njKessel/ESP32s3-NetworkClock/docs/images/24hourClockHome.jpg

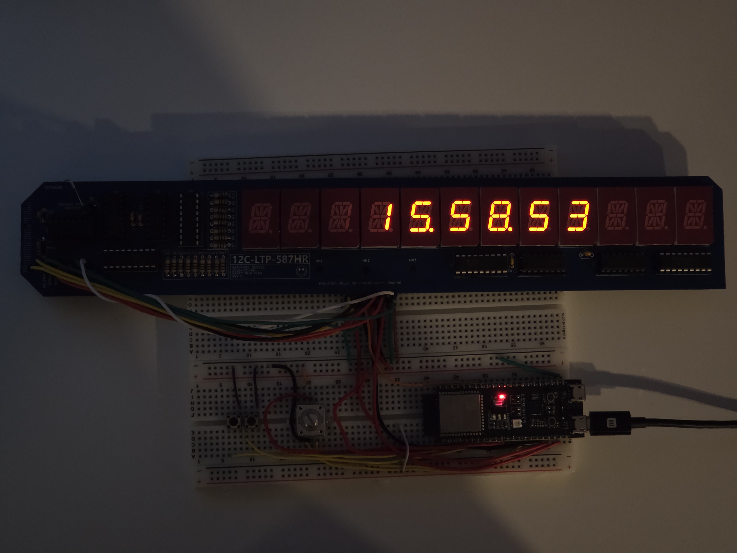
docs/images/24hourClockHome.jpg
