njKessel/ESP32s3-NetworkClock/docs/images/stopwatch.jpg

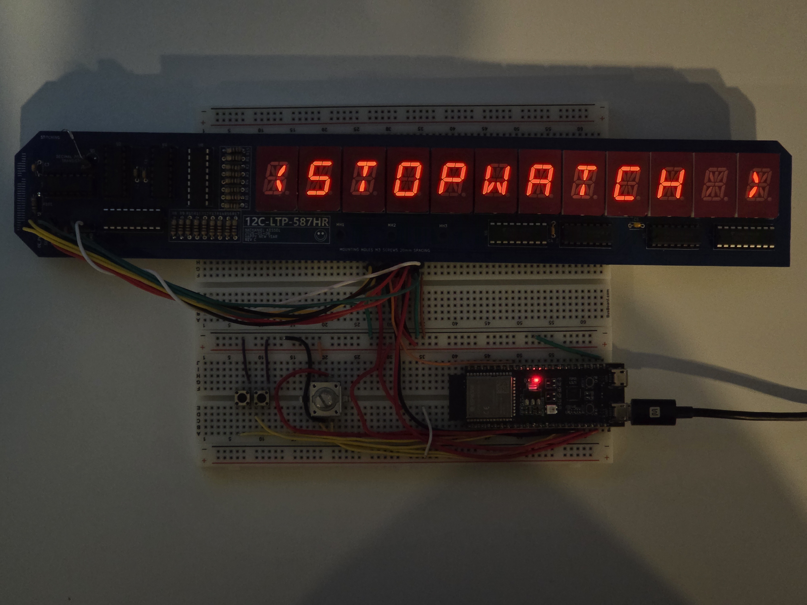
docs/images/stopwatch.jpg
