njKessel/ESP32s3-NetworkClock/README.md

# ESP32s3-NetworkClock
ESP32-S3 smart clock with LED display, weather, moon phase, temperature, Google Calendar
