njKessel/ESP32s3-NetworkClock/docs/design/2026-18-01-AlarmImplementation.pdf

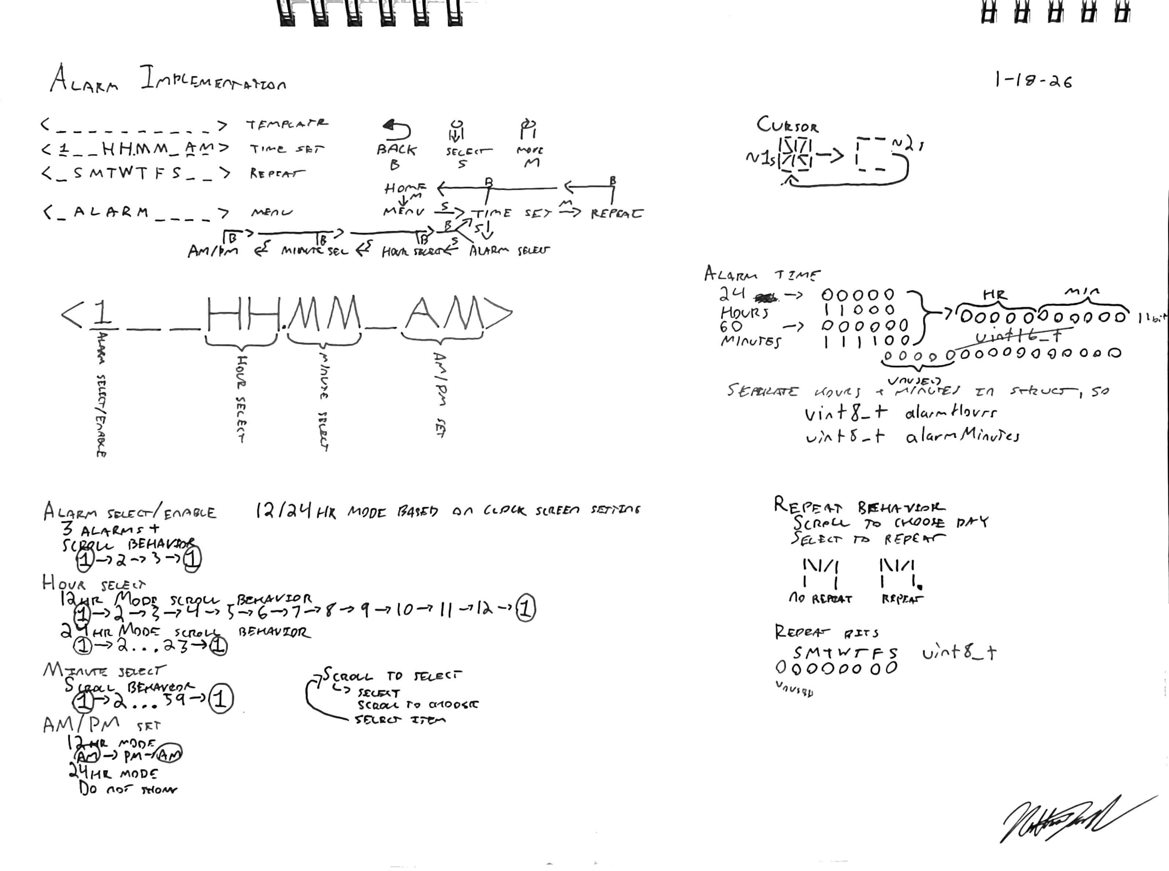
[picture p3: page 1]
