njKessel/ESP32s3-NetworkClock/docs/images/alarmEdit.jpg

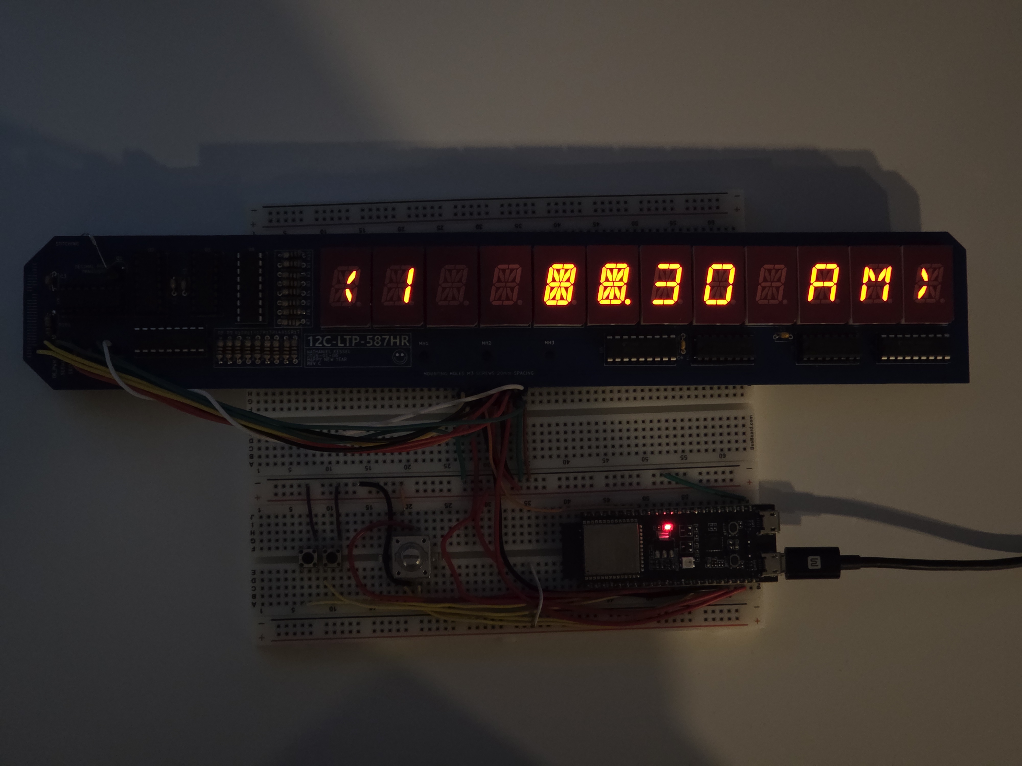
docs/images/alarmEdit.jpg
