njKessel/ESP32s3-NetworkClock/docs/images/alarmOption.jpg

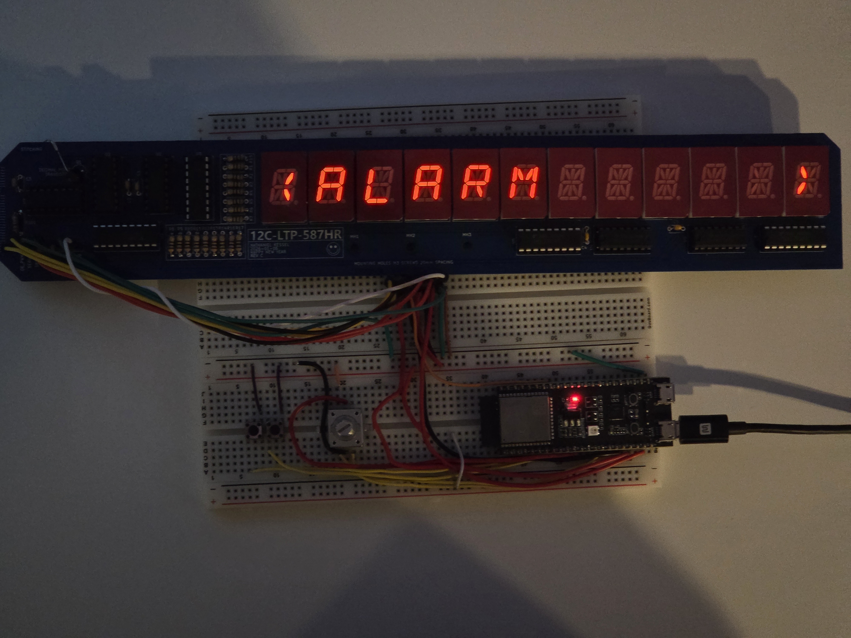
docs/images/alarmOption.jpg
