njKessel/ESP32s3-NetworkClock/docs/images/alarmRepeatScreen.jpg

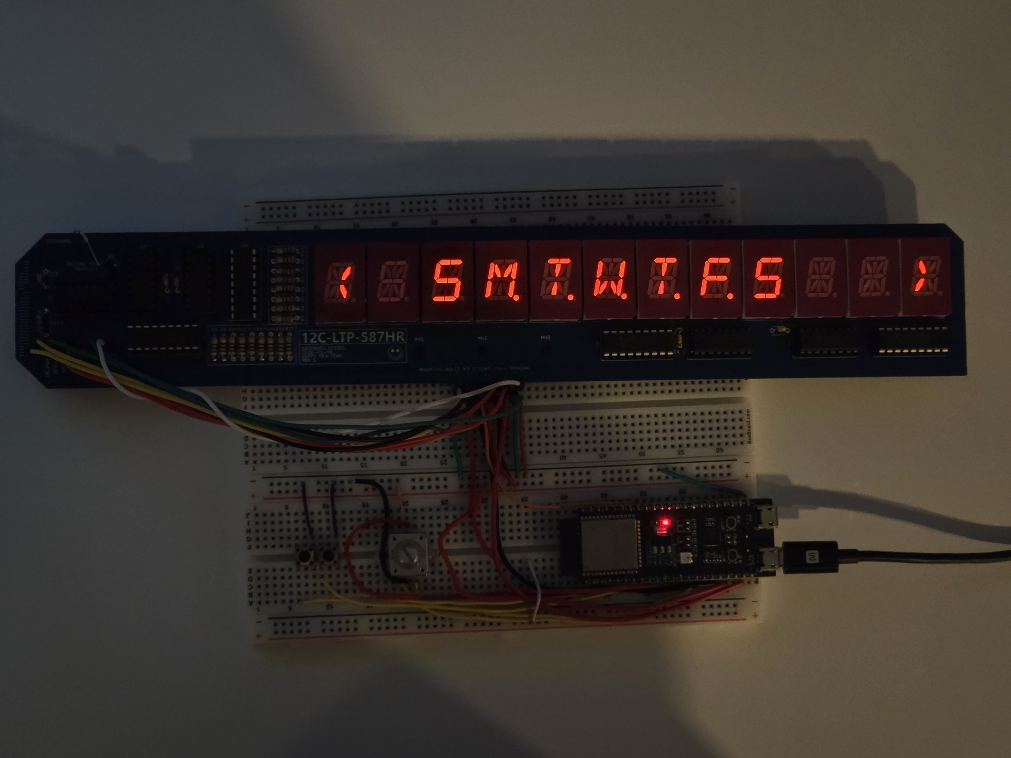
docs/images/alarmRepeatScreen.jpg
