njKessel/ESP32s3-NetworkClock/docs/images/clockHome.jpg

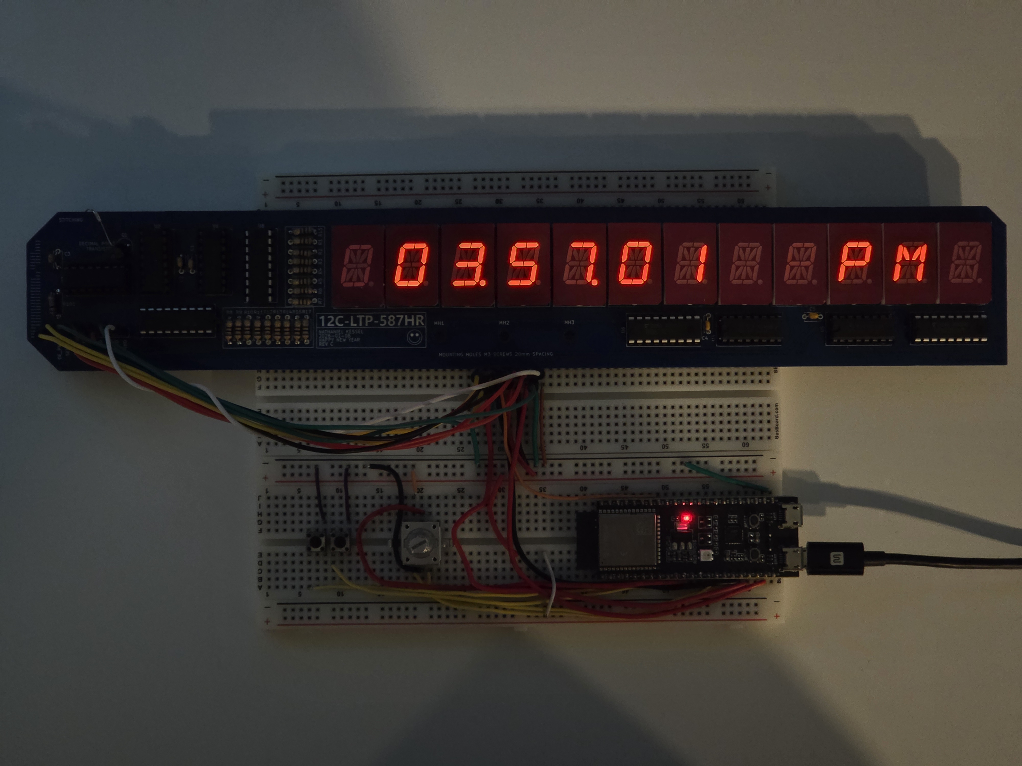
docs/images/clockHome.jpg
