njKessel/ESP32s3-NetworkClock/docs/images/clockNav.jpg

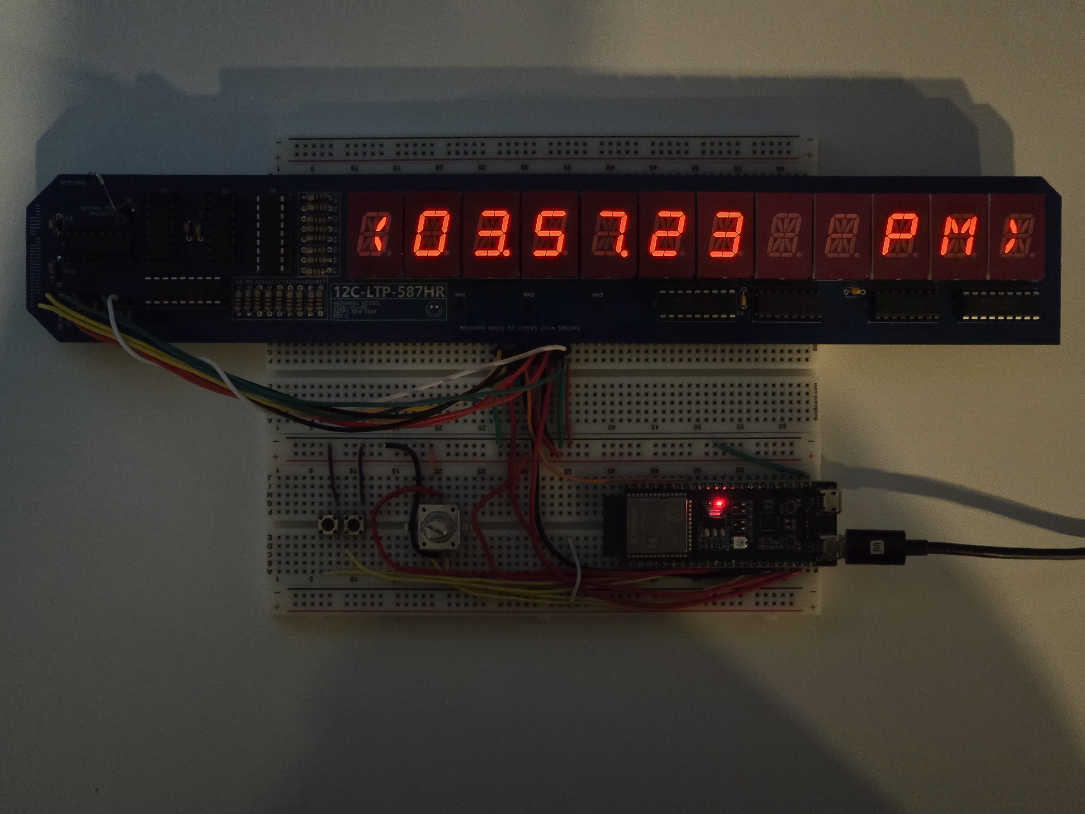
docs/images/clockNav.jpg
