njKessel/ESP32s3-NetworkClock/docs/images/timerInProgress.jpg

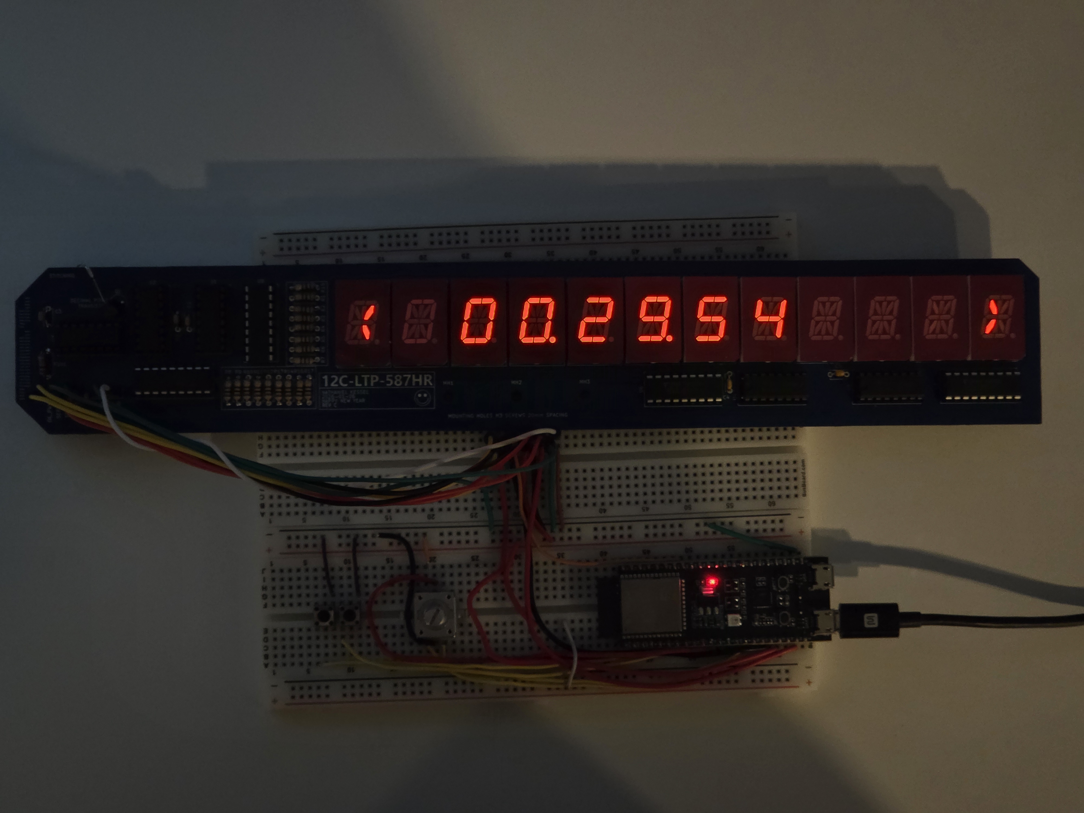
docs/images/timerInProgress.jpg
