njKessel/ESP32s3-NetworkClock/docs/images/timerNotif.jpg

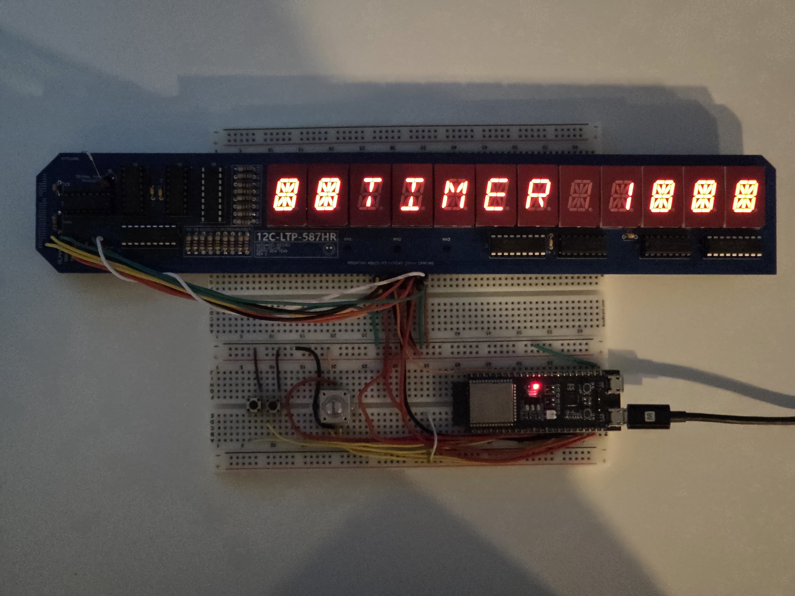
docs/images/timerNotif.jpg
