njKessel/ESP32s3-NetworkClock/docs/images/timerOption.jpg

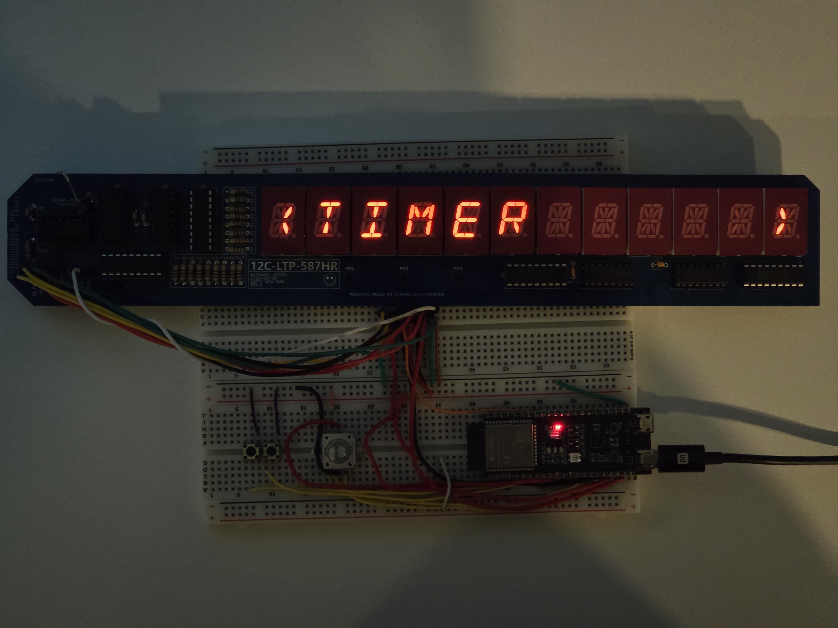
docs/images/timerOption.jpg
