njKessel/ESP32s3-NetworkClock/docs/images/timeZoneOption.jpg

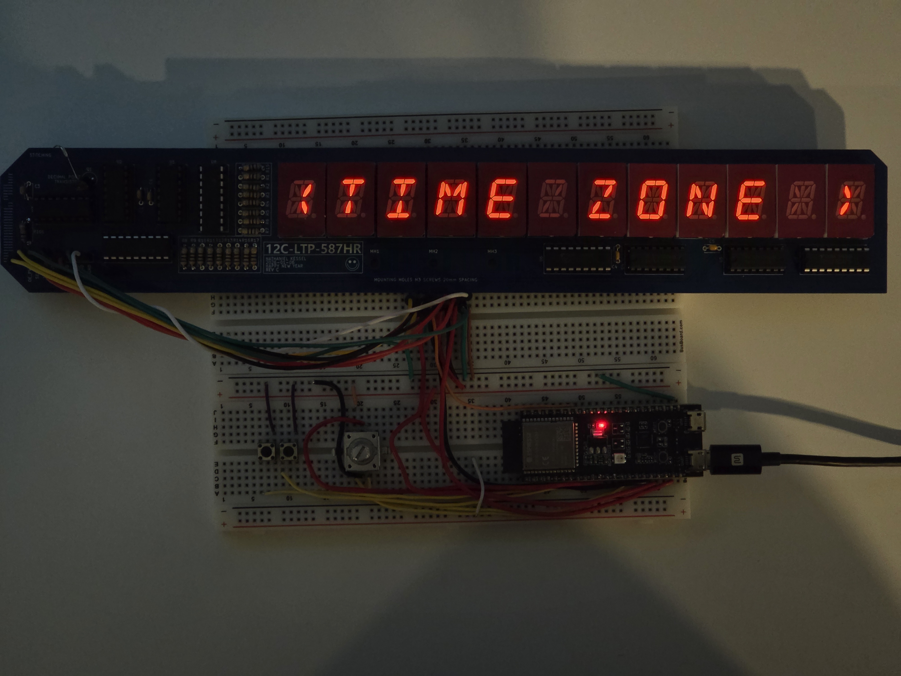
docs/images/timeZoneOption.jpg
