njKessel/ESP32s3-NetworkClock/docs/images/timeZoneSelect.jpg

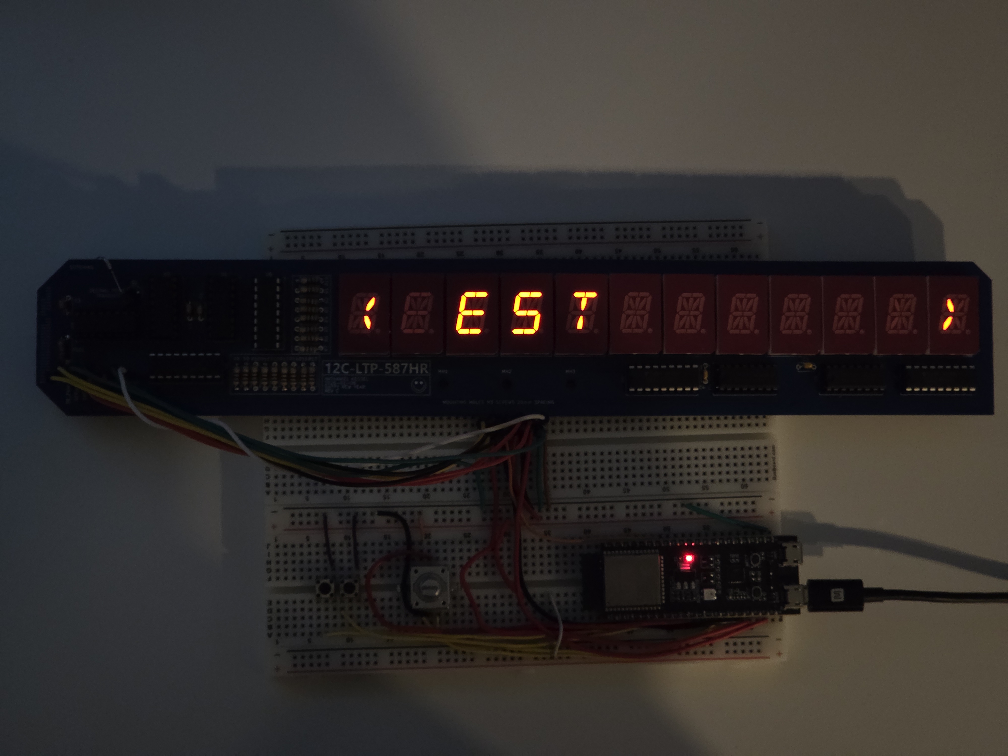
docs/images/timeZoneSelect.jpg
