njKessel/ESP32s3-NetworkClock/docs/scope/SDA_EOD2025-11-04.png

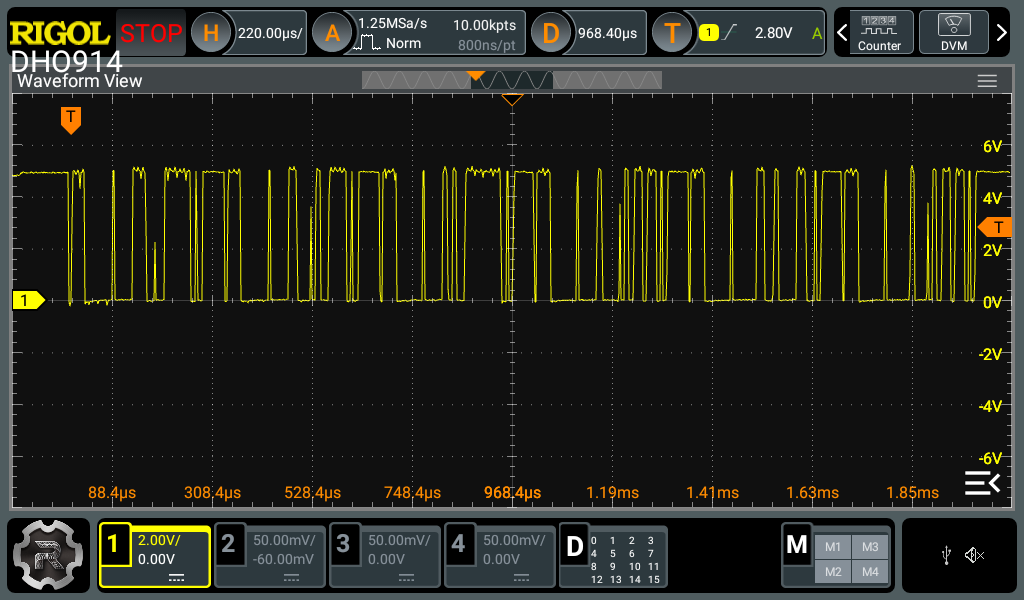
docs/scope/SDA_EOD2025-11-04.png
