njKessel/ESP32s3-NetworkClock/hardware/PCB/breadboardDisplayPCB/displayboard/displayboard.step

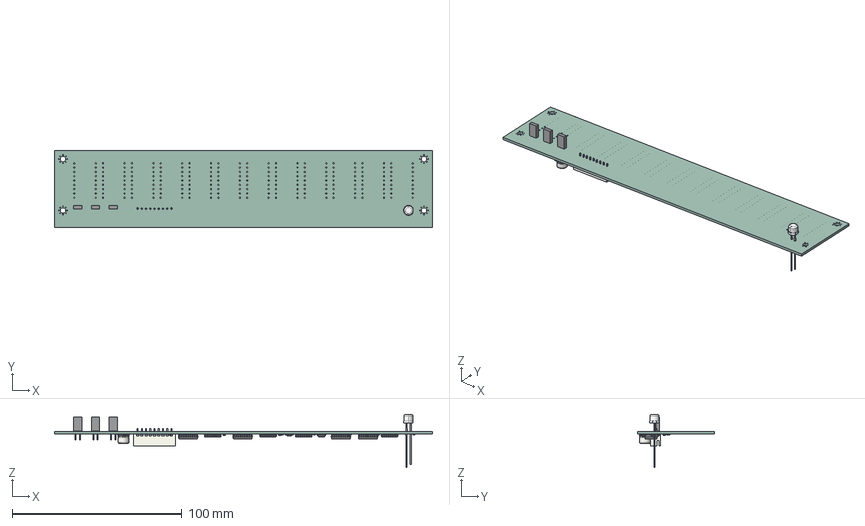
[picture p15: CAD file, 2026-04-21]
hardware/PCB/breadboardDisplayPCB/displayboard/displayboard.step
223.0 x 45.3 x 31.4 mm
TEPT5700
Leads x 3
R_0805_2012Metric x 18
SOIC-18W_7.5x11.6mm_P1.27mm x 4
C_0603_1608Metric x 6
SOIC-16_3.9x9.9mm_P1.27mm x 5
R_0603_1608Metric x 4
JST_XH_B9B-XH-A_1x09_P2.50mm_Vertical
SOT-23
CP_Elec_6.3x5.4
displayboard_PCB
