njKessel/ESP32s3-NetworkClock/hardware/PCB/breadboardDisplayPCB/displayboard/PDF/displayboard.pdf

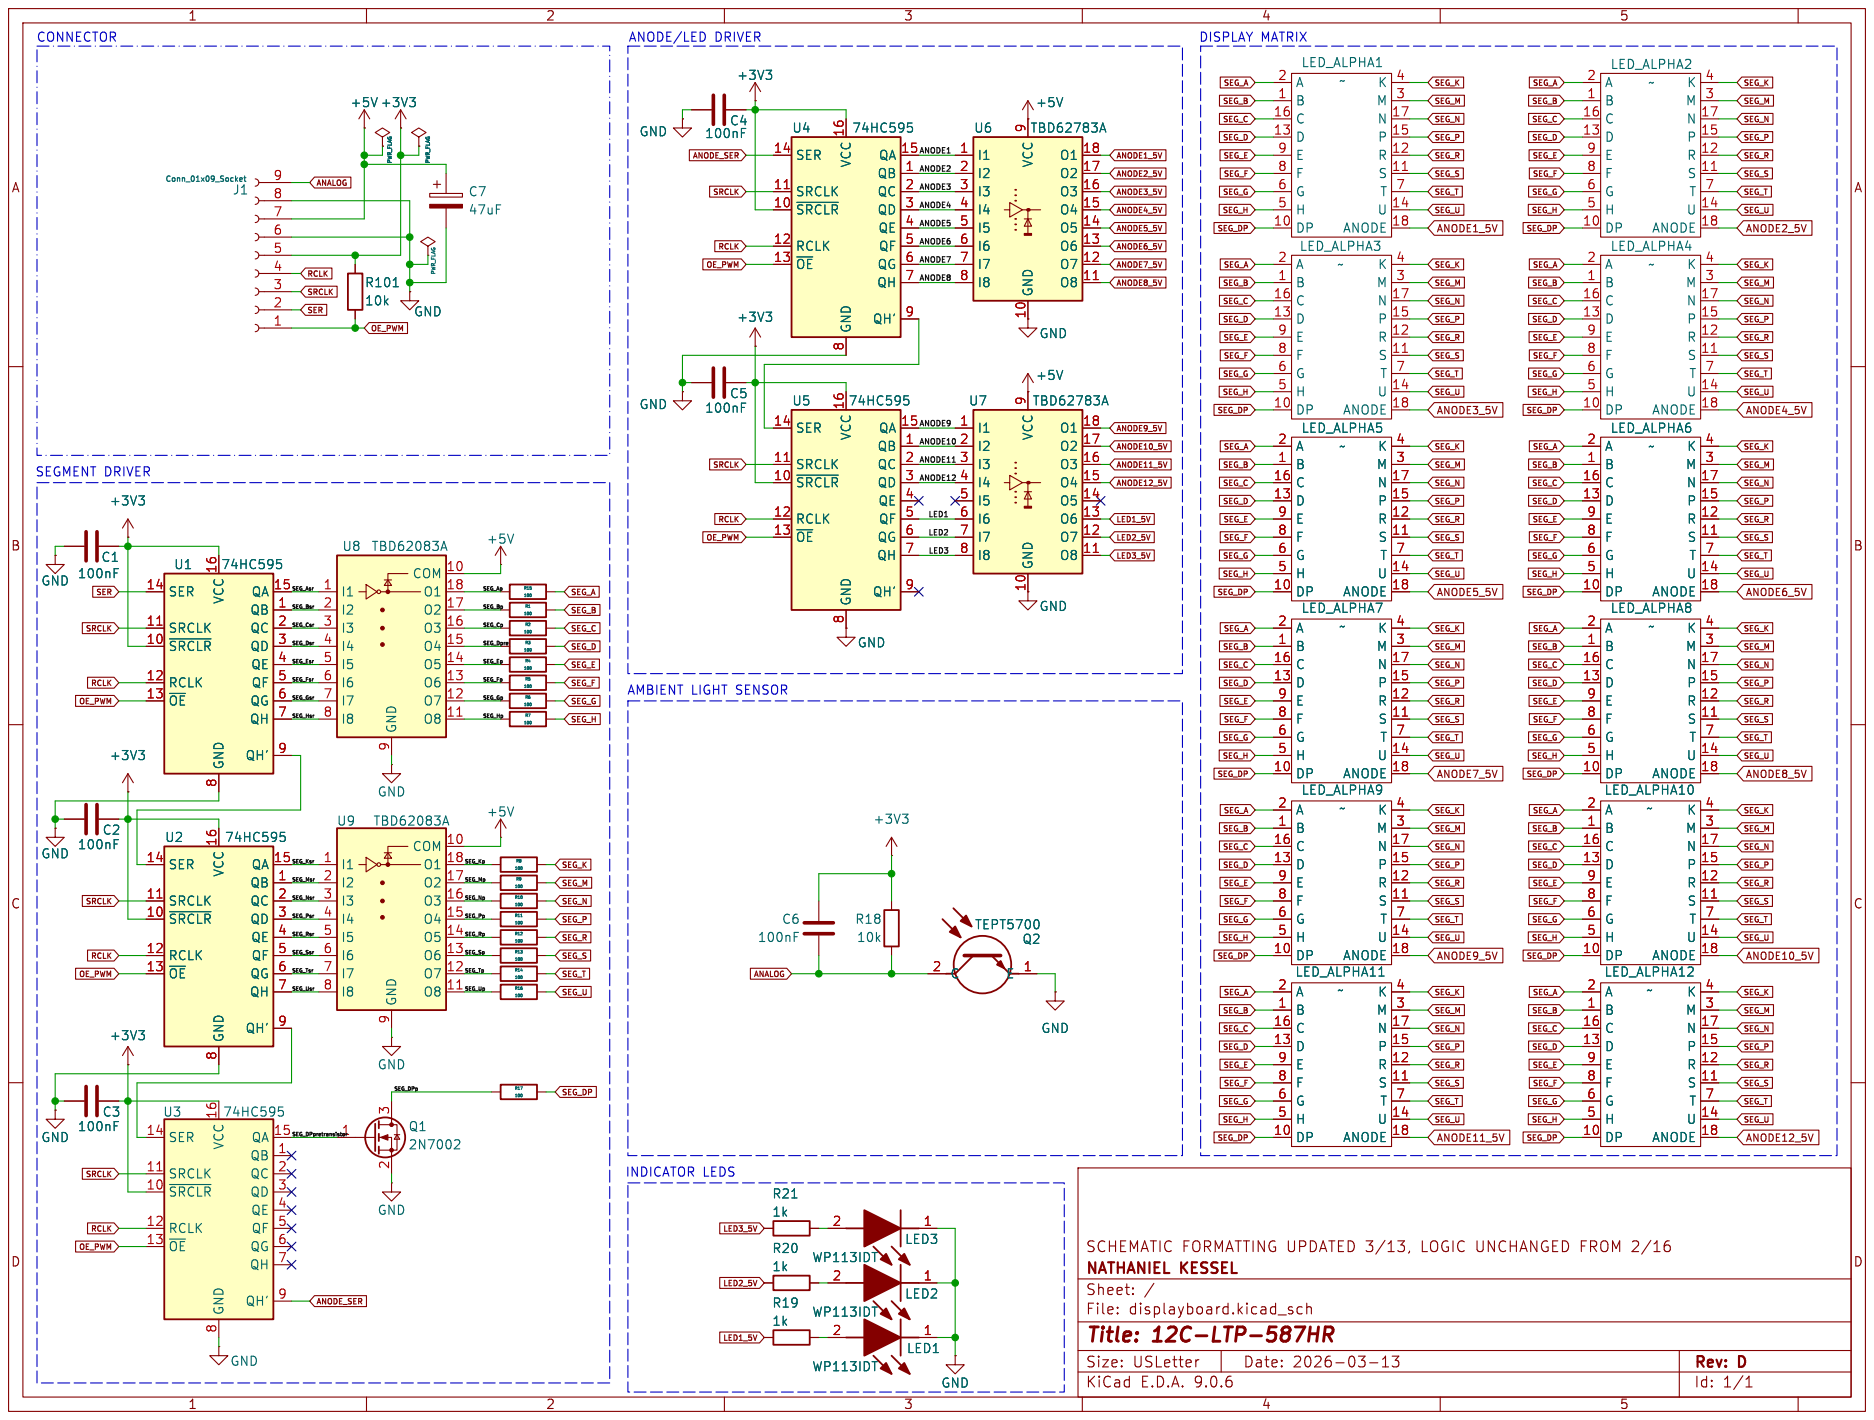
[picture p16: page 1]

8 QA 15 QB 1 QC 2 QD 3 QE 4 QF 5 QG 6 QH 7 QH' 9 GND U4 74HC595 GND

8 QA 15 QB 1 QC 2 QD 3 QE 4 QF 5 QG 6 QH 7 QH' 9 GND GND GND GND

8 QA 15 QB 1 QC 2 QD 3 QE 4 QF 5 QG 6 QH 7 QH' 9 U5 74HC595 +5V GND

8 QA 15 QB 1 QC 2 QD 3 QE 4 QF 5 QG 6 QH 7 QH' 9 +5V GND

9 GND 10 O1 18 O2 17 O3 16 O4 15 O5 14 O6 13 O7 12 O8 11 U5 74HC595 SER 14 SRCLK 11 ~{SRCLR} 10 RCLK 12 ~{OE} 13 VCC 16 GND

SER

100nFC3
1k GND GND

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
