njKessel/ESP32s3-NetworkClock/hardware/PCB/buttonPCB/buttons/PDF/buttons.pdf

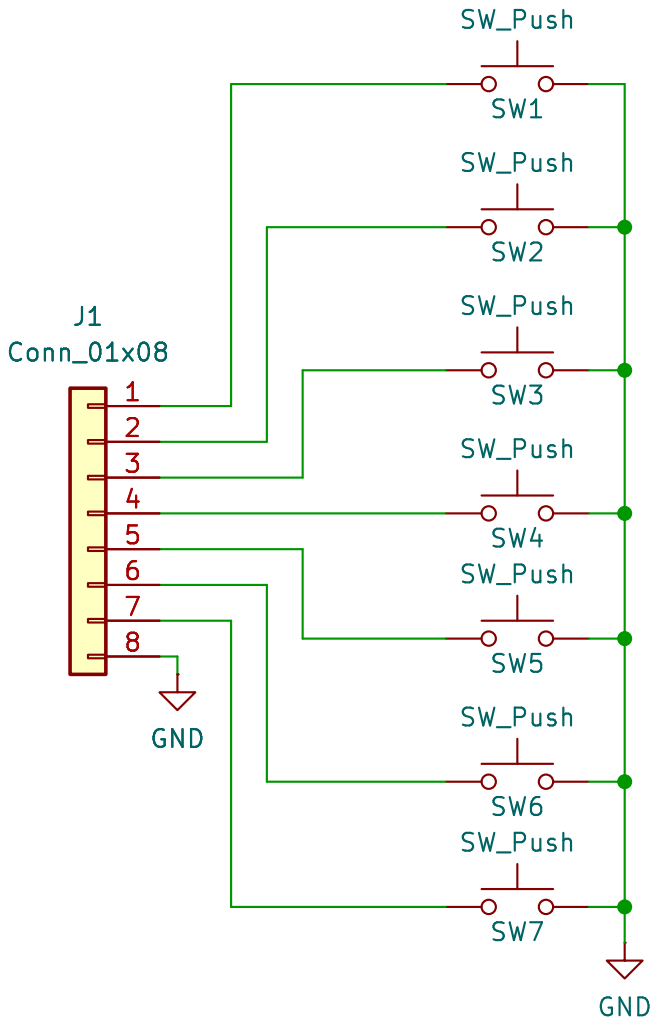
[picture p17: page 1]

Id: 1/1 Title: BUTTON PANEL FOR ESP32 CLOCK
