njKessel/ESP32s3-NetworkClock/hardware/PCB/mainClockPCB/mainClockPCB/PDF/mainClockPCB.pdf

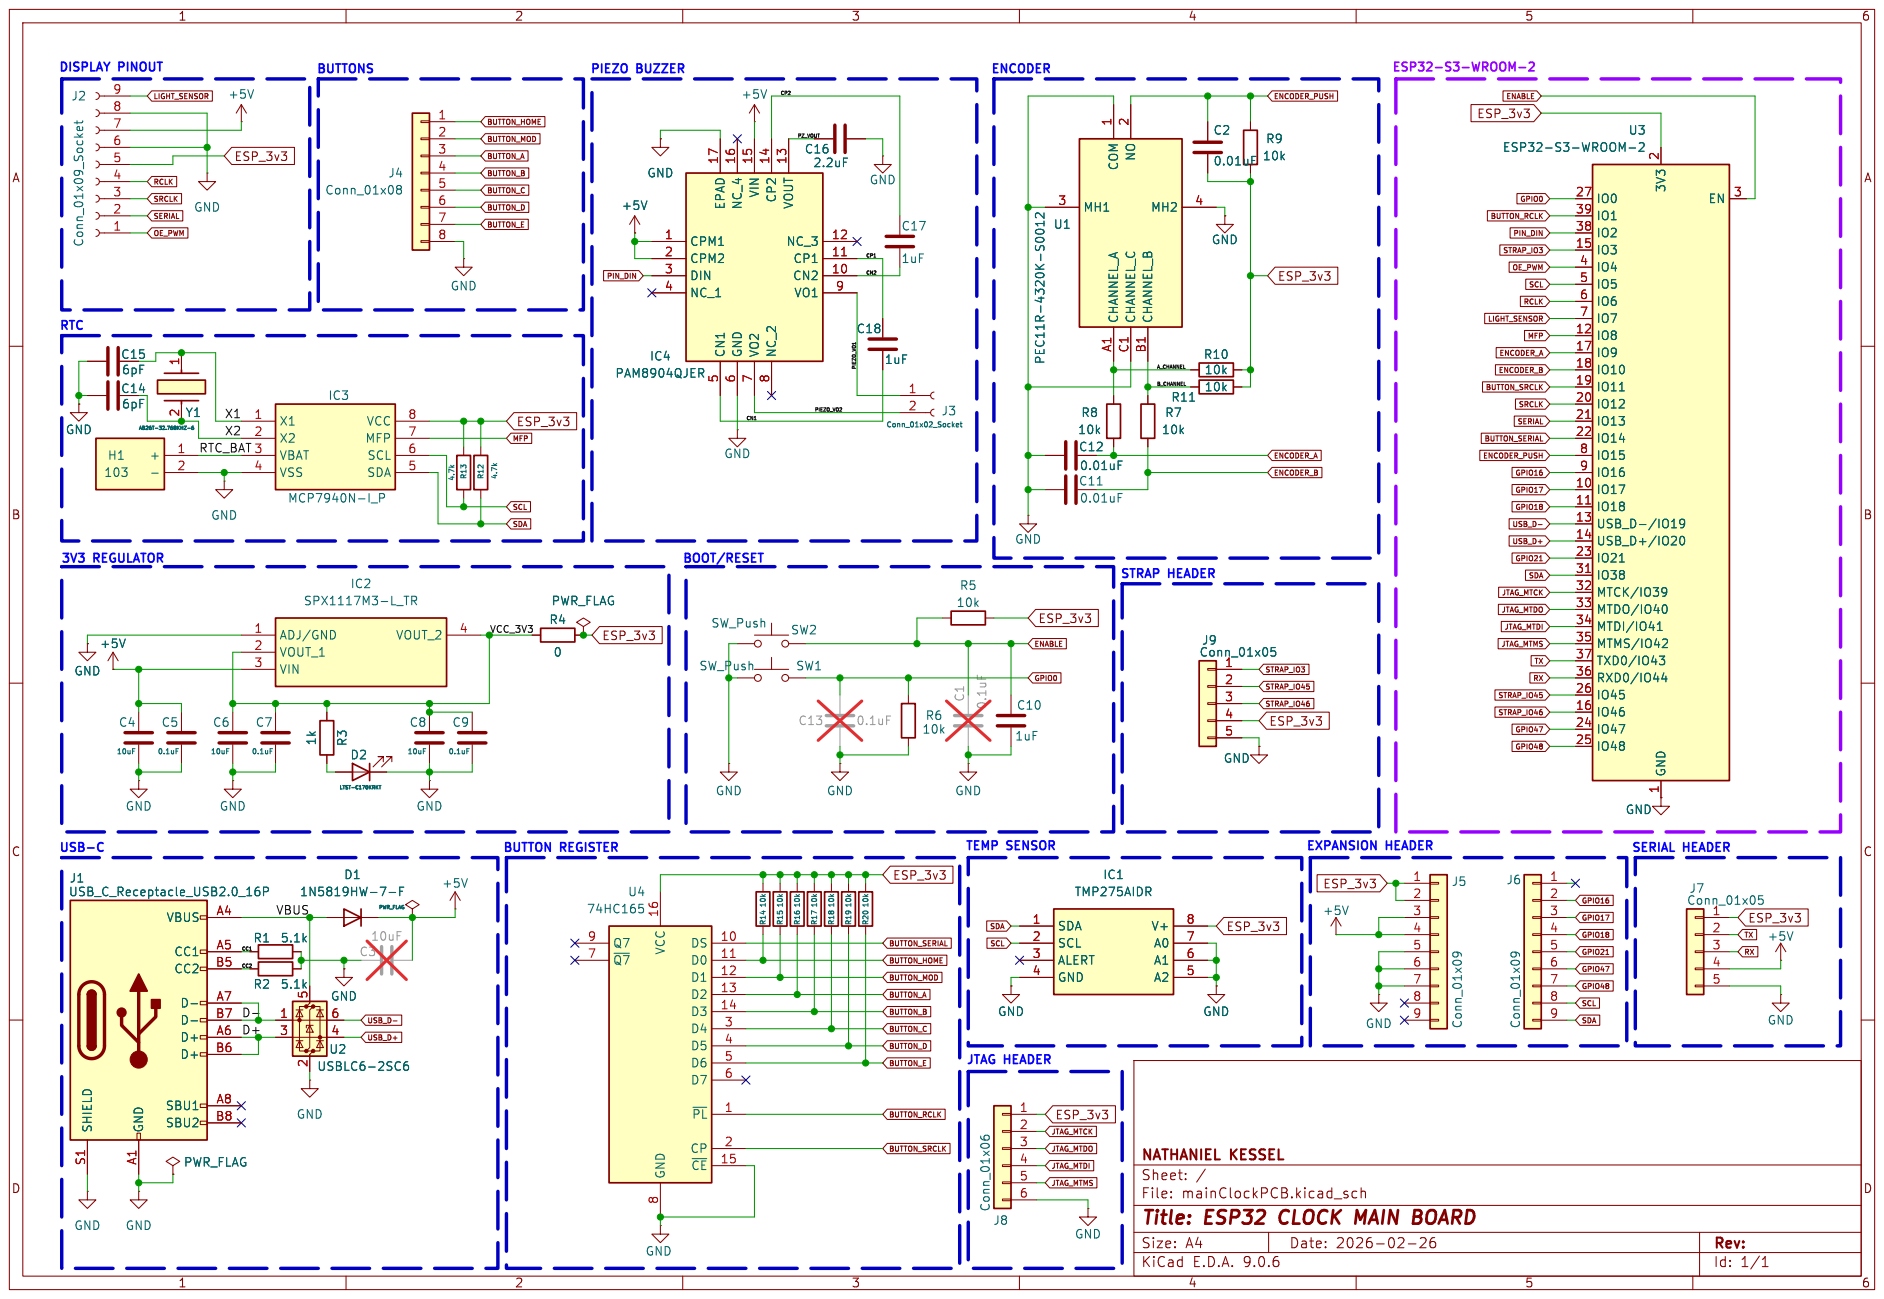
[picture p18: page 1]

2 CHANNEL_C C1 CHANNEL_B B1 MH2 4 U1 PEC11R-4320K-S0012 SDA 1 SCL 2 ALERT 3 GND 4 V+ 8 A0 7 A1 6 A2 5

IO38 31 MTCK/IO39 32 MTDO/IO40 33 MTDI/IO41 34 MTMS/IO42 35 TXD0/IO43 37 RXD0/IO44 36

Id: 1/1 Title: ESP32 CLOCK MAIN BOARD
