njKessel/ESP32s3-NetworkClock/hardware/PCB/breadboardDisplayPCB/displayboard/PDF/displayboard-B_Cu.pdf

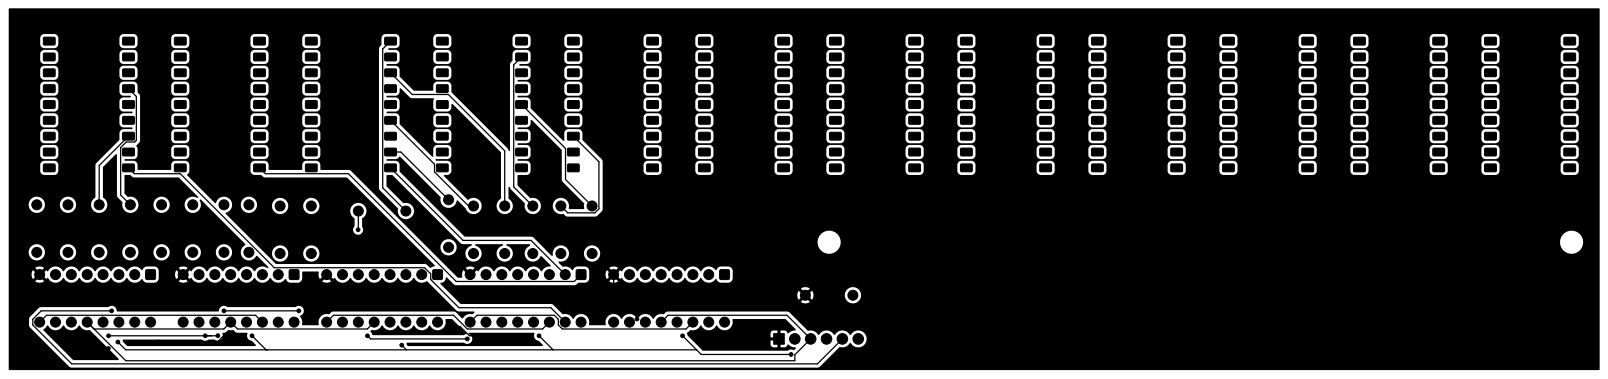
[picture p19: page 1]
