njKessel/ESP32s3-NetworkClock/hardware/PCB/breadboardDisplayPCB/displayboard/PDF/displayboard-B_Mask.pdf

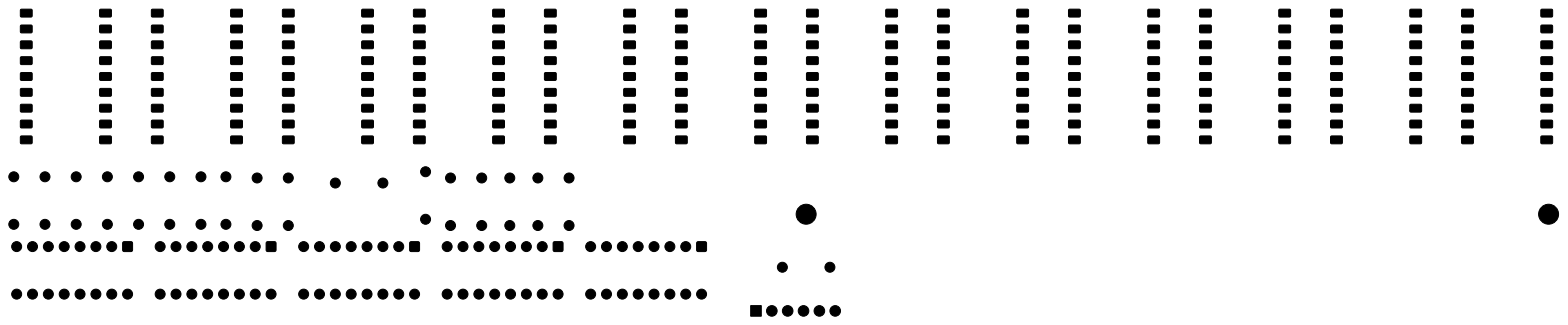
[picture p20: page 1]
