njKessel/ESP32s3-NetworkClock/hardware/PCB/breadboardDisplayPCB/displayboard/PDF/displayboard-B_Paste.pdf

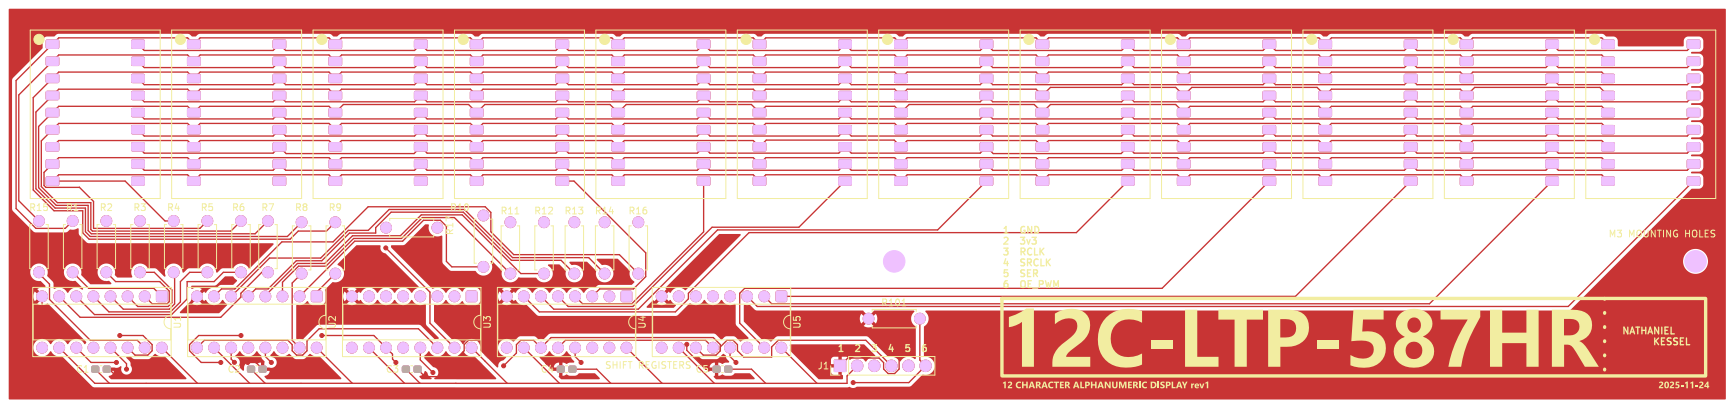
[picture p21: page 1]
