njKessel/ESP32s3-NetworkClock/hardware/PCB/breadboardDisplayPCB/displayboard/PDF/displayboard-B_Silkscreen.pdf

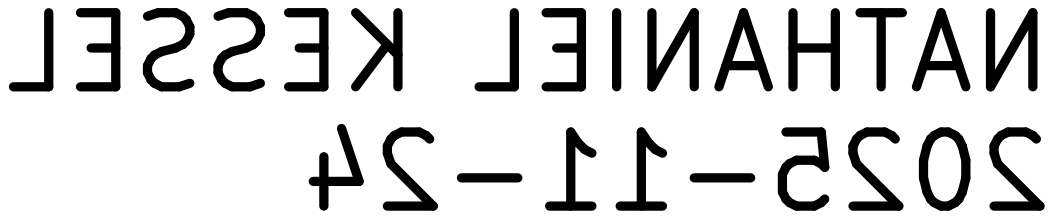
[picture p22: page 1]
