njKessel/ESP32s3-NetworkClock/hardware/PCB/breadboardDisplayPCB/displayboard/PDF/displayboard-F_Cu.pdf

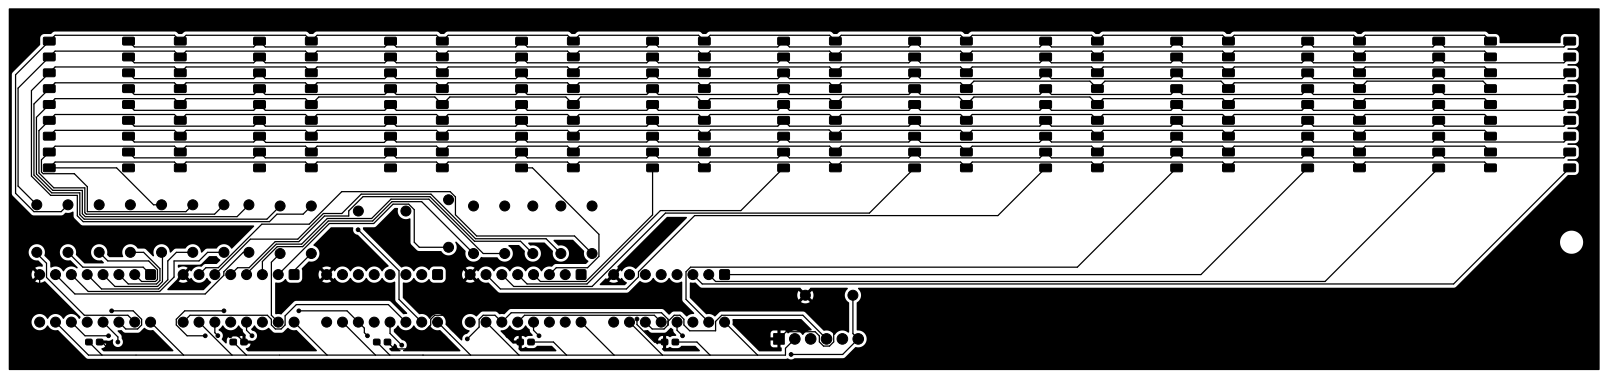
[picture p23: page 1]
