njKessel/ESP32s3-NetworkClock/hardware/PCB/breadboardDisplayPCB/displayboard/PDF/displayboard-F_Silkscreen.pdf

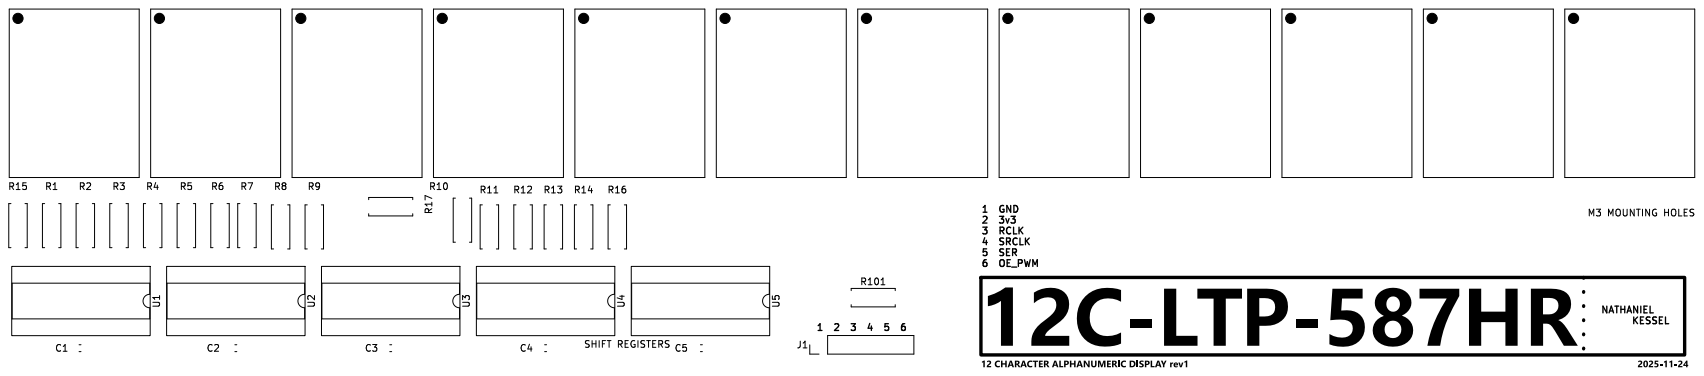
[picture p26: page 1]
