njKessel/ESP32s3-NetworkClock/hardware/PCB/mainClockPCB/mainClockPCB/mainClockPCB.kicad_pcb

## KiCad design hardware/PCB/mainClockPCB/mainClockPCB/mainClockPCB.kicad_pcb (2026-08-13)

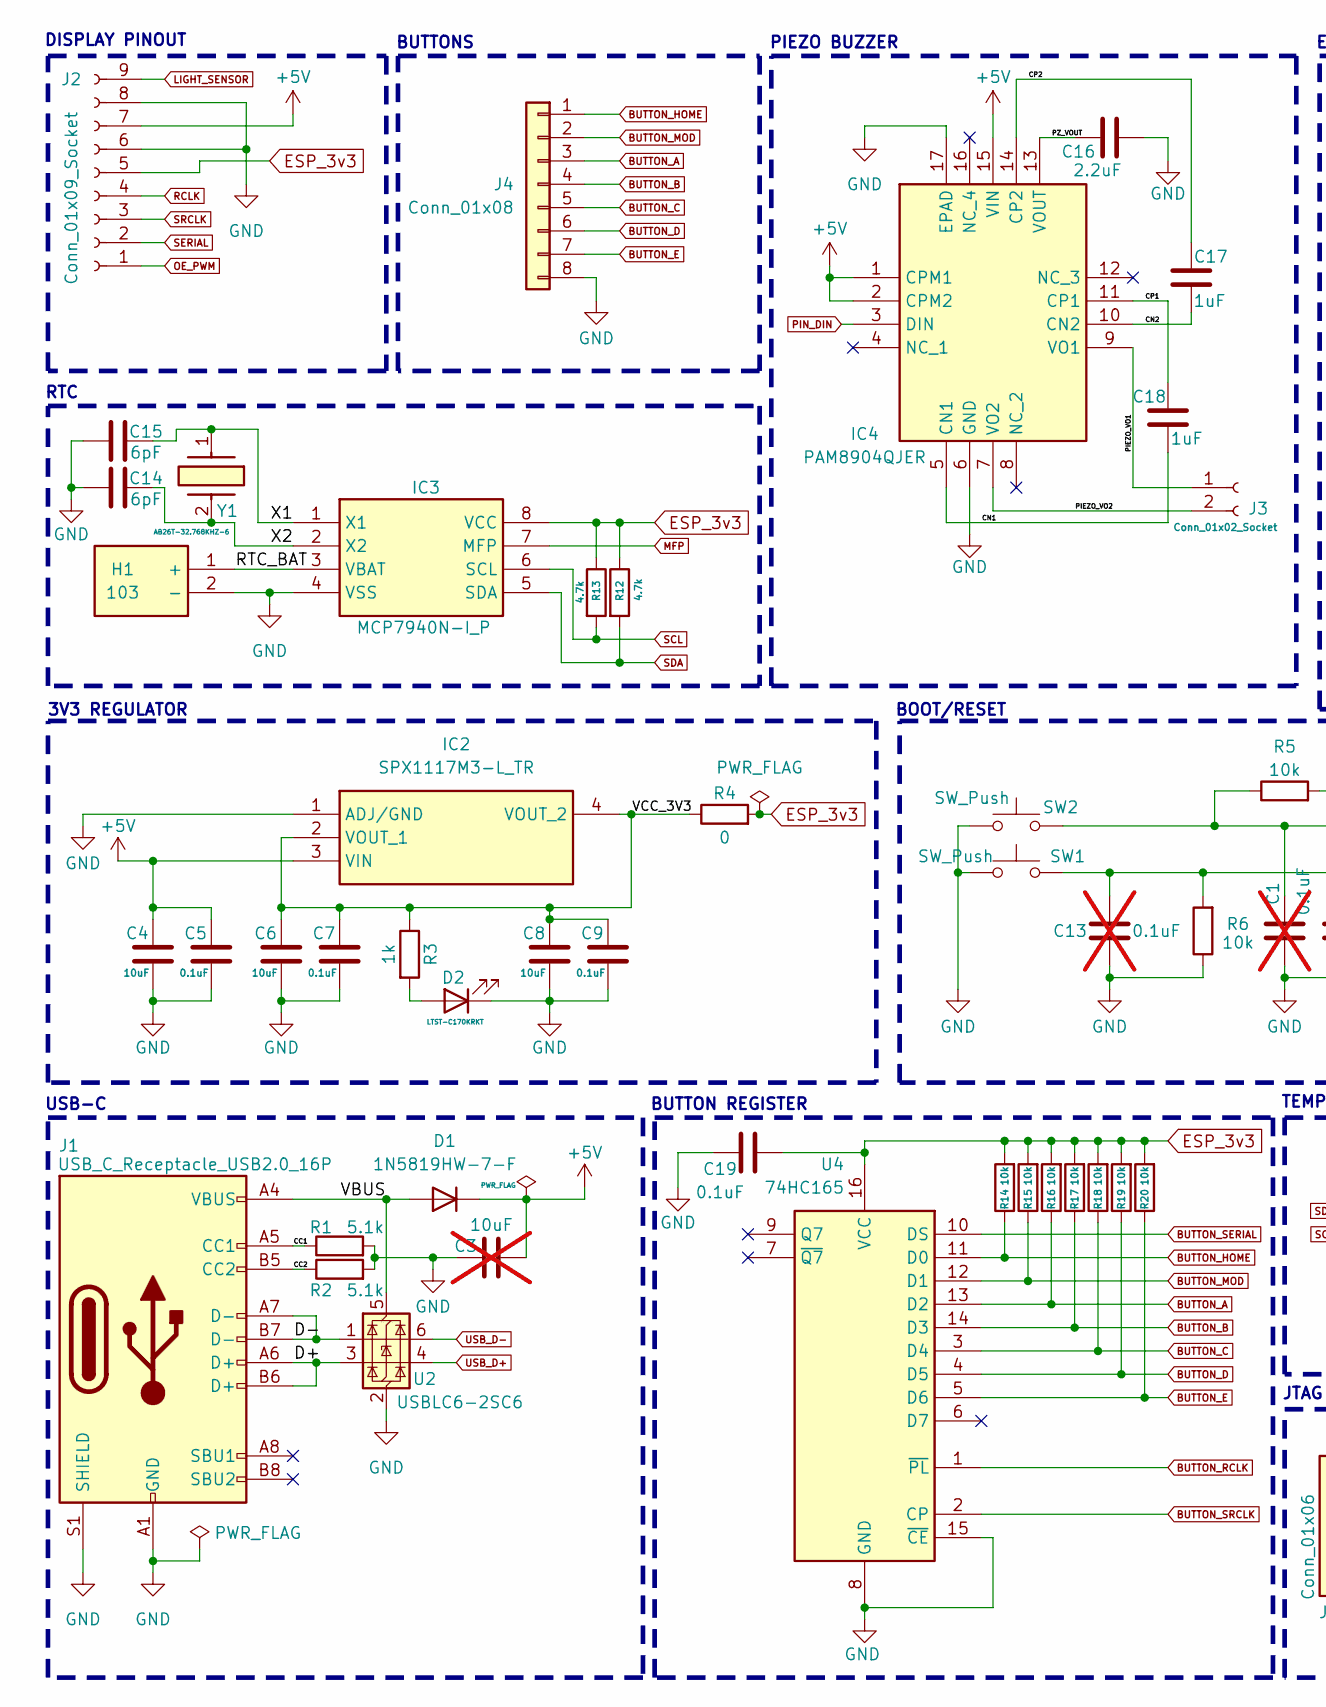
[picture p27: schematic mainClockPCB.kicad_sch, ESP32 CLOCK MAIN BOARD, part in row 1, column 1]

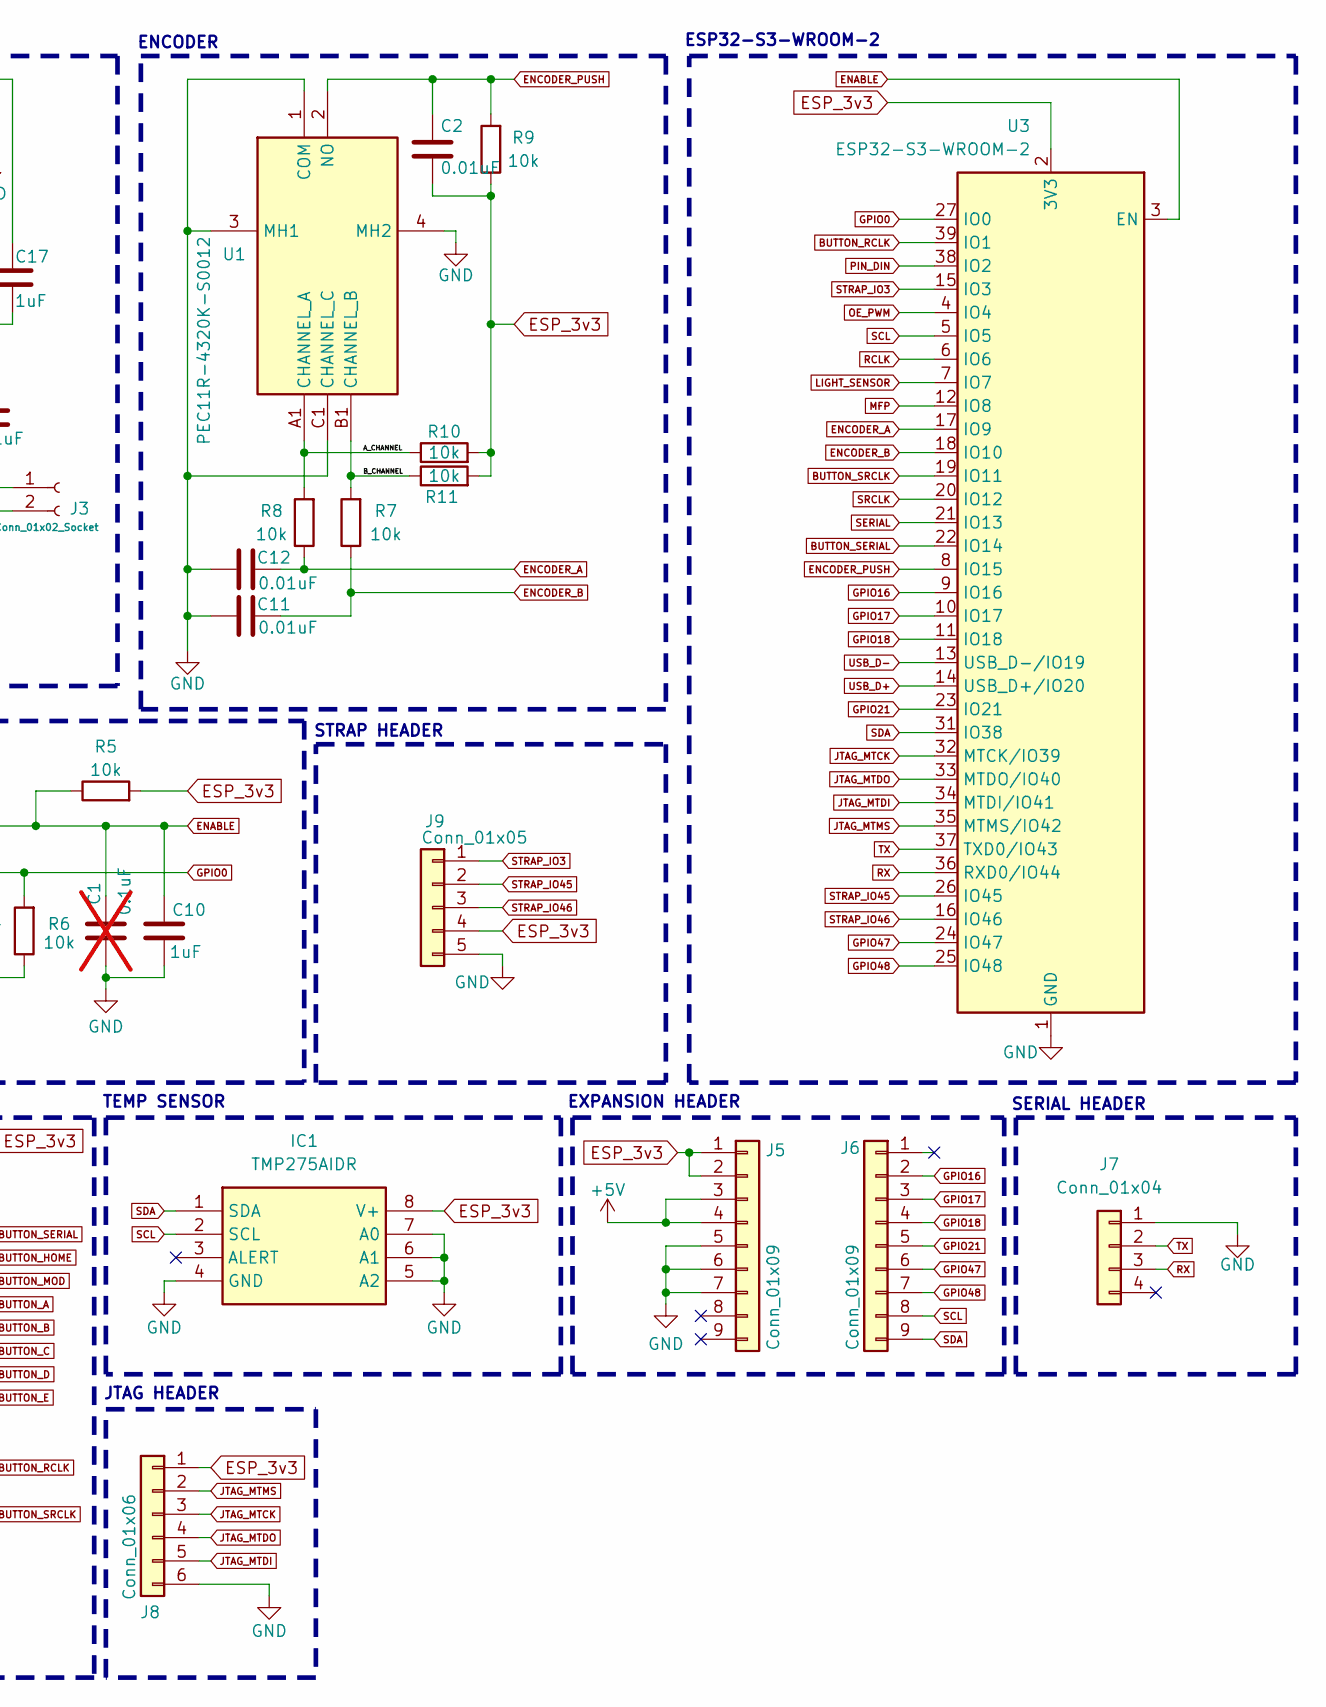
[picture p28: schematic mainClockPCB.kicad_sch, ESP32 CLOCK MAIN BOARD, part in row 1, column 2]

Parts:
C1, C13: 0.1uF; C_0603_1608Metric_Pad1.08x0.95mm_HandSolder; Voltage 50V; Tolerance 10%; not fitted
C2, C11, C12: 0.01uF; C_0603_1608Metric_Pad1.08x0.95mm_HandSolder
C3: 10uF; C_0805_2012Metric_Pad1.18x1.45mm_HandSolder; not fitted
C4, C6, C8: 10uF; C_0805_2012Metric_Pad1.18x1.45mm_HandSolder
C5, C7, C9, C19: 0.1uF; C_0603_1608Metric_Pad1.08x0.95mm_HandSolder
C10, C17, C18: 1uF; C_0603_1608Metric_Pad1.08x0.95mm_HandSolder
C14, C15: 6pF; C_0603_1608Metric_Pad1.08x0.95mm_HandSolder
C16: 2.2uF; C_0603_1608Metric_Pad1.08x0.95mm_HandSolder
D1: 1N5819HW-7-F; D_SOD-123
D2: LTST-C170KRKT; LED_0805_2012Metric_Pad1.15x1.40mm_HandSolder
H1: 103; Manufacturer_Part_Number 103; Mouser Part Number 534-103
IC1: TMP275AIDR; SOIC127P600X175-8N; Manufacturer_Part_Number TMP275AIDR; Mouser Part Number 595-TMP275AIDR
IC2: SPX1117M3-L_TR; SOT230P700X180-4N; Manufacturer_Part_Number SPX1117M3-L/TR; Mouser Part Number 701-SPX1117M3-L/TR
IC3: MCP7940N-I_P; DIP781W56P254L950H533Q8N; Manufacturer_Part_Number MCP7940N-I/P; Mouser Part Number 579-MCP7940N-I/P
IC4: PAM8904QJER; QFN50P300X300X65-17N-D; Manufacturer_Part_Number PAM8904QJER; Mouser Part Number 621-PAM8904QJER
J1: USB_C_Receptacle_USB2.0_16P; USB_C_Receptacle_GCT_USB4085
J2: Conn_01x09_Socket; JST_XH_B9B-XH-A_1x09_P2.50mm_Vertical
J3: Conn_01x02_Socket; JST_XH_B2B-XH-A_1x02_P2.50mm_Vertical
J4: Conn_01x08; JST_XH_B8B-XH-A_1x08_P2.50mm_Vertical
J5, J6: Conn_01x09; PinSocket_1x09_P2.54mm_Vertical
J7: Conn_01x04; PinSocket_1x04_P2.54mm_Vertical
J8: Conn_01x06; PinSocket_1x06_P2.54mm_Vertical
J9: Conn_01x05; PinSocket_1x05_P2.54mm_Vertical
R1, R2: 5.1k; R_0603_1608Metric_Pad0.98x0.95mm_HandSolder
R3: 1k; R_0603_1608Metric_Pad0.98x0.95mm_HandSolder
R4: 0; R_0603_1608Metric_Pad0.98x0.95mm_HandSolder
R5, R6, R7, R8, R9, R10, R11, R14, R15, R16, R17, R18, R19, R20: 10k; R_0603_1608Metric_Pad0.98x0.95mm_HandSolder
R12, R13: 4.7k; R_0603_1608Metric_Pad0.98x0.95mm_HandSolder
SW1, SW2: SW_Push; SW_PUSH_6mm_H5mm
U1: PEC11R-4320K-S0012; PEC11R4320KS0012; Manufacturer_Part_Number PEC11R-4320K-S0012; Mouser Part Number 652-PEC11R-4320K-S12
U2: USBLC6-2SC6; SOT-23-6
U3: ESP32-S3-WROOM-2
U4: 74HC165; DIP-16_W7.62mm_Socket
Y1: AB26T-32.768KHZ-6; AB26T32768KHZ6; Manufacturer_Part_Number AB26T-32.768KHZ-6; Mouser Part Number 815-AB26T-32.768K-6

Connections:
+5V: C3.2, C4.1, C5.1, D1.1 (K), IC2.3 (VIN), IC4.1 (CPM1), IC4.2 (CPM2), IC4.15 (VIN), J2.7, J5.3, J5.4
/A_CHANNEL: R8.2, R10.1, U1.A1 (CHANNEL_A)
/B_CHANNEL: R7.2, R11.1, U1.B1 (CHANNEL_B)
/CC1: J1.A5 (CC1), R1.1
/CC2: J1.B5 (CC2), R2.1
/CN1: C18.1, IC4.5 (CN1)
/CN2: C17.1, IC4.10 (CN2)
/CP1: C18.2, IC4.11 (CP1)
/CP2: C17.2, IC4.14 (CP2)
/D+: J1.A6 (D+), J1.B6 (D+), U2.3 (I/O2)
/D-: J1.A7 (D-), J1.B7 (D-), U2.1 (I/O1)
/PIEZO_VO1: IC4.9 (VO1), J3.1
/PIEZO_VO2: IC4.7 (VO2), J3.2
/PZ_VOUT: C16.1, IC4.13 (VOUT)
/RTC_BAT: H1.1 (+), IC3.3 (VBAT)
/VBUS: D1.2 (A), J1.A4 (VBUS), J1.A9 (VBUS), J1.B4 (VBUS), J1.B9 (VBUS), U2.5 (VBUS)
/VCC_3V3: C6.1, C7.1, C8.1, C9.1, IC2.2 (VOUT_1), IC2.4 (VOUT_2), R3.1, R4.1
/X1: C15.2, IC3.1 (X1), Y1.1
/X2: C14.2, IC3.2 (X2), Y1.2
BUTTON_A: J4.3, R16.1, U4.13 (D2)
BUTTON_B: J4.4, R17.1, U4.14 (D3)
BUTTON_C: J4.5, R18.1, U4.3 (D4)
BUTTON_D: J4.6, R19.1, U4.4 (D5)
BUTTON_E: J4.7, R20.1, U4.5 (D6)
BUTTON_HOME: J4.1, R14.1, U4.11 (D0)
BUTTON_MOD: J4.2, R15.1, U4.12 (D1)
BUTTON_RCLK: U3.39 (IO1), U4.1 (~PL)
BUTTON_SERIAL: U3.22 (IO14), U4.10 (DS)
BUTTON_SRCLK: U3.19 (IO11), U4.2 (CP)
ENABLE: C1.1, C10.1, R5.1, SW2.2, U3.3 (EN)
ENCODER_A: C12.2, R8.1, U3.17 (IO9)
ENCODER_B: C11.1, R7.1, U3.18 (IO10)
ENCODER_PUSH: C2.1, R9.2, U1.2 (NO), U3.8 (IO15)
ESP_3v3: C2.2, C19.2, IC1.8 (V+), IC3.8 (VCC), J2.5, J5.1, J5.2, J8.1, J9.4, R4.2, R5.2, R9.1, R10.2, R11.2, R12.1, R13.1, R14.2, R15.2, R16.2, R17.2, R18.2, R19.2, R20.2, U3.2 (3V3), U4.16 (VCC)
GND: C1.2, C3.1, C4.2, C5.2, C6.2, C7.2, C8.2, C9.2, C10.2, C11.2, C12.1, C13.2, C14.1, C15.1, C16.2, C19.1, D2.1 (K), H1.2 (-), IC1.4 (GND), IC1.5 (A2), IC1.6 (A1), IC1.7 (A0), IC2.1 (ADJ/GND), IC3.4 (VSS), IC4.6 (GND), IC4.17 (EPAD), J1.A1 (GND), J1.A12 (GND), J1.B1 (GND), J1.B12 (GND), J1.S1 (SHIELD), J2.6, J2.8, J4.8, J5.5, J5.6, J5.7, J7.1, J8.6, J9.5, R1.2, R2.2, R6.1, SW1.1, SW2.1, U1.1 (COM), U1.3 (MH1), U1.4 (MH2), U1.C1 (CHANNEL_C), U2.2 (GND), U3.1 (GND), U3.40 (GND), U3.41 (GND), U4.8 (GND), U4.15 (~CE)
GPIO0: C13.1, R6.2, SW1.2, U3.27 (IO0)
GPIO16: J6.2, U3.9 (IO16)
GPIO17: J6.3, U3.10 (IO17)
GPIO18: J6.4, U3.11 (IO18)
GPIO21: J6.5, U3.23 (IO21)
GPIO47: J6.6, U3.24 (IO47)
GPIO48: J6.7, U3.25 (IO48)
JTAG_MTCK: J8.3, U3.32 (MTCK/IO39)
JTAG_MTDI: J8.5, U3.34 (MTDI/IO41)
JTAG_MTDO: J8.4, U3.33 (MTDO/IO40)
JTAG_MTMS: J8.2, U3.35 (MTMS/IO42)
LIGHT_SENSOR: J2.9, U3.7 (IO7)
MFP: IC3.7 (MFP), U3.12 (IO8)
unnamed: D2.2 (A), R3.2
OE_PWM: J2.1, U3.4 (IO4)
PIN_DIN: IC4.3 (DIN), U3.38 (IO2)
RCLK: J2.4, U3.6 (IO6)
RX: J7.3, U3.36 (RXD0/IO44)
SCL: IC1.2 (SCL), IC3.6 (SCL), J6.8, R13.2, U3.5 (IO5)
SDA: IC1.1 (SDA), IC3.5 (SDA), J6.9, R12.2, U3.31 (IO38)
SERIAL: J2.2, U3.21 (IO13)
SRCLK: J2.3, U3.20 (IO12)
STRAP_IO3: J9.1, U3.15 (IO3)
STRAP_IO45: J9.2, U3.26 (IO45)
STRAP_IO46: J9.3, U3.16 (IO46)
TX: J7.2, U3.37 (TXD0/IO43)
USB_D+: U2.4 (I/O2), U3.14 (USB_D+/IO20)
USB_D-: U2.6 (I/O1), U3.13 (USB_D-/IO19)

Notes on the sheet:
ESP32-S3-WROOM-2
TEMP SENSOR
EXPANSION HEADER
BUTTONS
BOOT/RESET
DISPLAY PINOUT
USB-C
JTAG HEADER
SERIAL HEADER
BUTTON REGISTER
3V3 REGULATOR
PIEZO BUZZER
RTC
STRAP HEADER
ENCODER

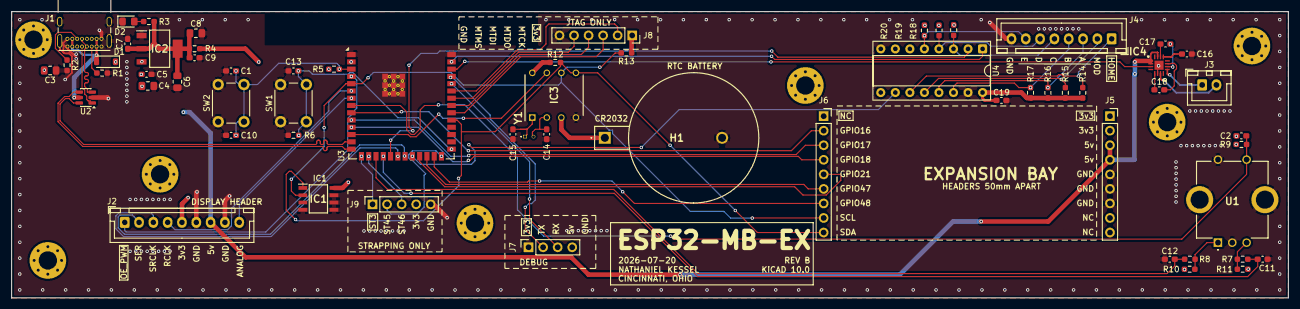
[picture p29: board mainClockPCB.kicad_pcb from above]

Board: 4 copper layers, 223.0 x 50.0 mm, 62 parts (0 on the bottom side), 63 nets.
