njKessel/ESP32s3-NetworkClock/hardware/PCB/buttonPCB/buttons/buttons.kicad_pcb

## KiCad design hardware/PCB/buttonPCB/buttons/buttons.kicad_pcb (2026-04-23)

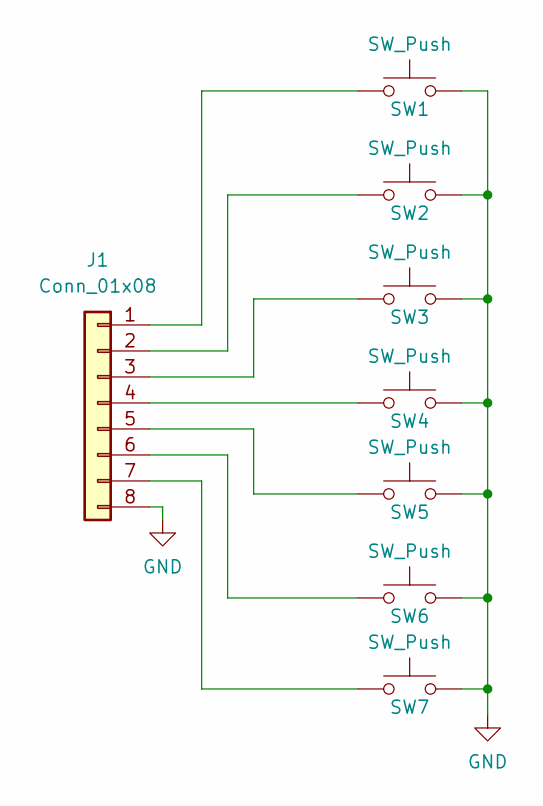
[picture p30: schematic buttons.kicad_sch, BUTTON PANEL FOR ESP32 CLOCK]

Parts:
J1: Conn_01x08; JST_XH_B8B-XH-A_1x08_P2.50mm_Vertical
SW1, SW2, SW3, SW4, SW5, SW6, SW7: SW_Push; SW_PUSH_6mm

Connections:
GND: J1.8, SW1.2, SW2.2, SW3.2, SW4.2, SW5.2, SW6.2, SW7.2
unnamed: J1.1, SW1.1
unnamed: J1.2, SW2.1
unnamed: J1.3, SW3.1
unnamed: J1.4, SW4.1
unnamed: J1.5, SW5.1
unnamed: J1.6, SW6.1
unnamed: J1.7, SW7.1

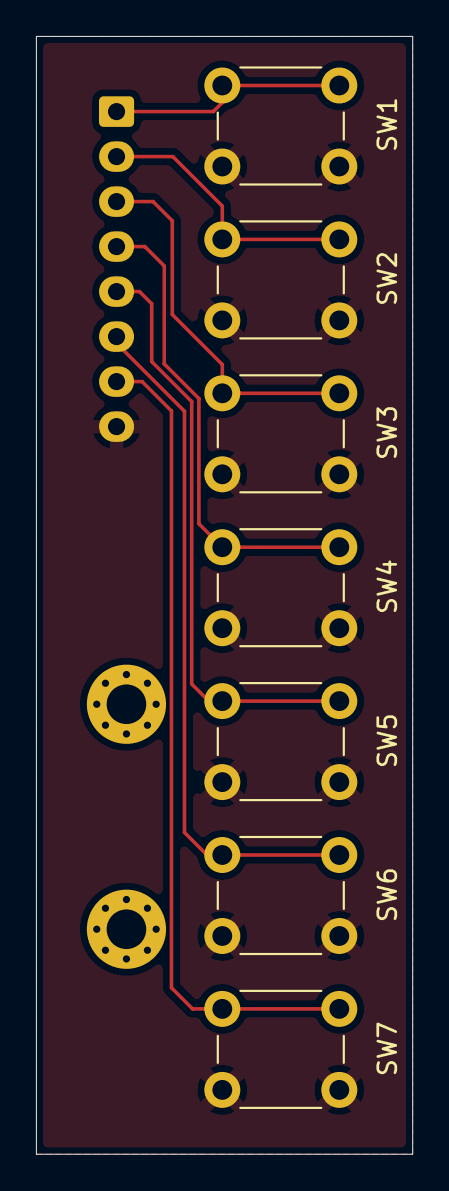
[picture p31: board buttons.kicad_pcb from above]

Board: 2 copper layers, 20.9 x 62.1 mm, 8 parts (1 on the bottom side), 8 nets.
