njKessel/ESP32s3-NetworkClock/hardware/PCB/breadboardDisplayPCB/displayboard/displayboard.kicad_pcb

## KiCad design hardware/PCB/breadboardDisplayPCB/displayboard/displayboard.kicad_pcb (2026-04-23)

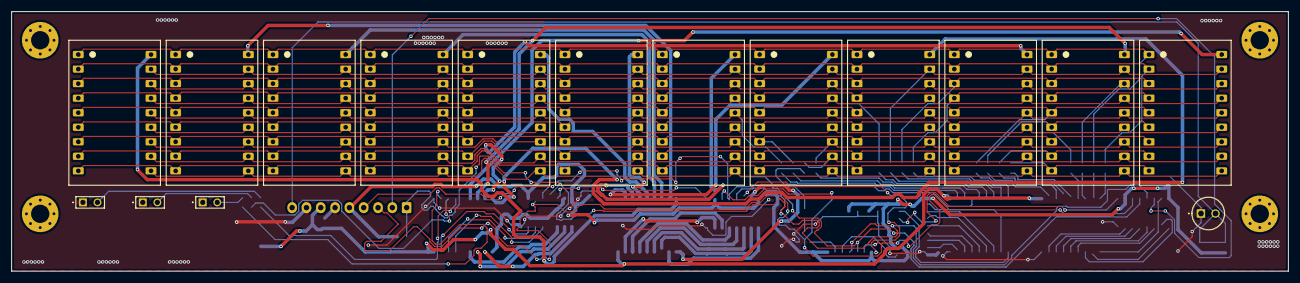
[picture p32: board displayboard.kicad_pcb from above]

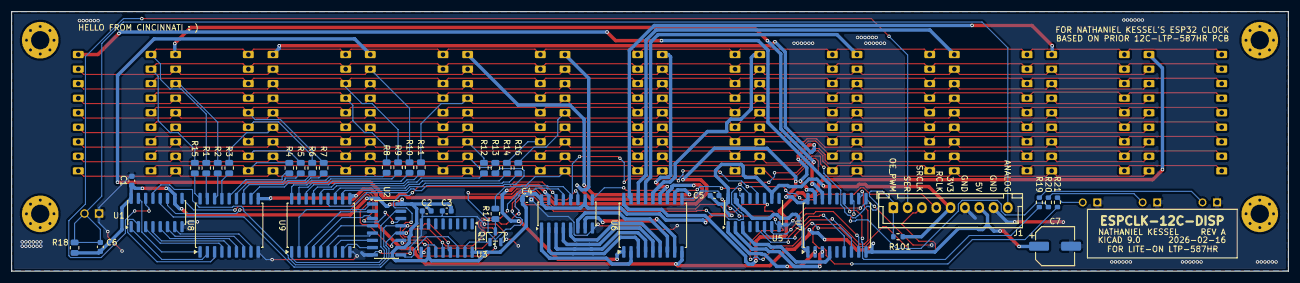
[picture p33: board displayboard.kicad_pcb from below]

Board: 2 copper layers, 223.0 x 45.3 mm, 56 parts (40 on the bottom side), 96 nets.

Parts:
C1, C2, C3, C4, C5, C6: 100nF; C_0603_1608Metric
C7: 47uF; CP_Elec_6.3x5.4
J1: Conn_01x09_Socket; JST_XH_B9B-XH-A_1x09_P2.50mm_Vertical
LED1, LED2, LED3: WP113IDT
LED_ALPHA1, LED_ALPHA2, LED_ALPHA3, LED_ALPHA4, LED_ALPHA5, LED_ALPHA6, LED_ALPHA7, LED_ALPHA8, LED_ALPHA9, LED_ALPHA10, LED_ALPHA11, LED_ALPHA12: LTP-587HR_DIP18
Q1: 2N7002; SOT-23
Q2: TEPT5700
R1, R2, R3, R4, R5, R6, R7, R8, R9, R10, R11, R12, R13, R14, R15, R16, R17: 100; R_0805_2012Metric
R18: 10k; R_0805_2012Metric
R19, R20, R21: 1k; R_0603_1608Metric
R101: 10k; R_0603_1608Metric
U1, U2, U3, U4, U5: 74HC595; SOIC-16_3.9x9.9mm_P1.27mm
U6, U7: TBD62783A; SOIC-18W_7.5x11.6mm_P1.27mm
U8, U9: TBD62083A; SOIC-18W_7.5x11.6mm_P1.27mm

Connections:
+3V3: C1.1, C2.2, C3.2, C4.1, C5.1, C6.1, J1.5, R18.1, R101.1, U1.10 (~SRCLR), U1.16 (VCC), U2.10 (~SRCLR), U2.16 (VCC), U3.10 (~SRCLR), U3.16 (VCC), U4.10 (~SRCLR), U4.16 (VCC), U5.10 (~SRCLR), U5.16 (VCC)
+5V: C7.1, J1.7, U6.9 (VCC), U7.9 (VCC), U8.10 (COM), U9.10 (COM)
/ANODE1: U4.15 (QA), U6.1 (I1)
/ANODE2: U4.1 (QB), U6.2 (I2)
/ANODE3: U4.2 (QC), U6.3 (I3)
/ANODE4: U4.3 (QD), U6.4 (I4)
/ANODE5: U4.4 (QE), U6.5 (I5)
/ANODE6: U4.5 (QF), U6.6 (I6)
/ANODE7: U4.6 (QG), U6.7 (I7)
/ANODE8: U4.7 (QH), U6.8 (I8)
/ANODE9: U5.15 (QA), U7.1 (I1)
/ANODE10: U5.1 (QB), U7.2 (I2)
/ANODE11: U5.2 (QC), U7.3 (I3)
/ANODE12: U5.3 (QD), U7.4 (I4)
/LED1: U5.5 (QF), U7.6 (I6)
/LED2: U5.6 (QG), U7.7 (I7)
/LED3: U5.7 (QH), U7.8 (I8)
/SEG_Ap: R15.1, U8.18 (O1)
/SEG_Asr: U1.15 (QA), U8.1 (I1)
/SEG_Bp: R1.1, U8.17 (O2)
/SEG_Bsr: U1.1 (QB), U8.2 (I2)
/SEG_Cp: R2.1, U8.16 (O3)
/SEG_Csr: U1.2 (QC), U8.3 (I3)
/SEG_DPp: Q1.3 (D), R17.1
/SEG_DPpretransistor: Q1.1 (G), U3.15 (QA)
/SEG_Dpre: R3.1, U8.15 (O4)
/SEG_Dsr: U1.3 (QD), U8.4 (I4)
/SEG_Ep: R4.1, U8.14 (O5)
/SEG_Esr: U1.4 (QE), U8.5 (I5)
/SEG_Fp: R5.1, U8.13 (O6)
/SEG_Fsr: U1.5 (QF), U8.6 (I6)
/SEG_Gp: R6.1, U8.12 (O7)
/SEG_Gsr: U1.6 (QG), U8.7 (I7)
/SEG_Hp: R7.1, U8.11 (O8)
/SEG_Hsr: U1.7 (QH), U8.8 (I8)
/SEG_Kp: R8.1, U9.18 (O1)
/SEG_Ksr: U2.15 (QA), U9.1 (I1)
/SEG_Mp: R9.1, U9.17 (O2)
/SEG_Msr: U2.1 (QB), U9.2 (I2)
/SEG_Np: R10.1, U9.16 (O3)
/SEG_Nsr: U2.2 (QC), U9.3 (I3)
/SEG_Pp: R11.1, U9.15 (O4)
/SEG_Psr: U2.3 (QD), U9.4 (I4)
/SEG_Rp: R12.1, U9.14 (O5)
/SEG_Rsr: U2.4 (QE), U9.5 (I5)
/SEG_Sp: R13.1, U9.13 (O6)
/SEG_Ssr: U2.5 (QF), U9.6 (I6)
/SEG_Tp: R14.1, U9.12 (O7)
/SEG_Tsr: U2.6 (QG), U9.7 (I7)
/SEG_Up: R16.1, U9.11 (O8)
/SEG_Usr: U2.7 (QH), U9.8 (I8)
ANALOG: C6.2, J1.9, Q2.2 (C), R18.2
ANODE1_5V: LED_ALPHA1.18 (ANODE), U6.18 (O1)
ANODE2_5V: LED_ALPHA2.18 (ANODE), U6.17 (O2)
ANODE3_5V: LED_ALPHA3.18 (ANODE), U6.16 (O3)
ANODE4_5V: LED_ALPHA4.18 (ANODE), U6.15 (O4)
ANODE5_5V: LED_ALPHA5.18 (ANODE), U6.14 (O5)
ANODE6_5V: LED_ALPHA6.18 (ANODE), U6.13 (O6)
ANODE7_5V: LED_ALPHA7.18 (ANODE), U6.12 (O7)
ANODE8_5V: LED_ALPHA8.18 (ANODE), U6.11 (O8)
ANODE9_5V: LED_ALPHA9.18 (ANODE), U7.18 (O1)
ANODE10_5V: LED_ALPHA10.18 (ANODE), U7.17 (O2)
ANODE11_5V: LED_ALPHA11.18 (ANODE), U7.16 (O3)
ANODE12_5V: LED_ALPHA12.18 (ANODE), U7.15 (O4)
ANODE_SER: U3.9 (QH'), U4.14 (SER)
GND: C1.2, C2.1, C3.1, C4.2, C5.2, C7.2, J1.6, J1.8, LED1.1 (K), LED2.1 (K), LED3.1 (K), Q1.2 (S), Q2.1 (E), U1.8 (GND), U2.8 (GND), U3.8 (GND), U4.8 (GND), U5.8 (GND), U6.10 (GND), U7.10 (GND), U8.9 (GND), U9.9 (GND)
LED1_5V: R19.1, U7.13 (O6)
LED2_5V: R20.1, U7.12 (O7)
LED3_5V: R21.1, U7.11 (O8)
unnamed: LED1.2 (A), R19.2
unnamed: LED2.2 (A), R20.2
unnamed: LED3.2 (A), R21.2
unnamed: U1.9 (QH'), U2.14 (SER)
unnamed: U2.9 (QH'), U3.14 (SER)
unnamed: U4.9 (QH'), U5.14 (SER)
OE_PWM: J1.1, R101.2, U1.13 (~OE), U2.13 (~OE), U3.13 (~OE), U4.13 (~OE), U5.13 (~OE)
RCLK: J1.4, U1.12 (RCLK), U2.12 (RCLK), U3.12 (RCLK), U4.12 (RCLK), U5.12 (RCLK)
SEG_A: LED_ALPHA1.2 (A), LED_ALPHA2.2 (A), LED_ALPHA3.2 (A), LED_ALPHA4.2 (A), LED_ALPHA5.2 (A), LED_ALPHA6.2 (A), LED_ALPHA7.2 (A), LED_ALPHA8.2 (A), LED_ALPHA9.2 (A), LED_ALPHA10.2 (A), LED_ALPHA11.2 (A), LED_ALPHA12.2 (A), R15.2
SEG_B: LED_ALPHA1.1 (B), LED_ALPHA2.1 (B), LED_ALPHA3.1 (B), LED_ALPHA4.1 (B), LED_ALPHA5.1 (B), LED_ALPHA6.1 (B), LED_ALPHA7.1 (B), LED_ALPHA8.1 (B), LED_ALPHA9.1 (B), LED_ALPHA10.1 (B), LED_ALPHA11.1 (B), LED_ALPHA12.1 (B), R1.2
SEG_C: LED_ALPHA1.16 (C), LED_ALPHA2.16 (C), LED_ALPHA3.16 (C), LED_ALPHA4.16 (C), LED_ALPHA5.16 (C), LED_ALPHA6.16 (C), LED_ALPHA7.16 (C), LED_ALPHA8.16 (C), LED_ALPHA9.16 (C), LED_ALPHA10.16 (C), LED_ALPHA11.16 (C), LED_ALPHA12.16 (C), R2.2
SEG_D: LED_ALPHA1.13 (D), LED_ALPHA2.13 (D), LED_ALPHA3.13 (D), LED_ALPHA4.13 (D), LED_ALPHA5.13 (D), LED_ALPHA6.13 (D), LED_ALPHA7.13 (D), LED_ALPHA8.13 (D), LED_ALPHA9.13 (D), LED_ALPHA10.13 (D), LED_ALPHA11.13 (D), LED_ALPHA12.13 (D), R3.2
SEG_DP: LED_ALPHA1.10 (DP), LED_ALPHA2.10 (DP), LED_ALPHA3.10 (DP), LED_ALPHA4.10 (DP), LED_ALPHA5.10 (DP), LED_ALPHA6.10 (DP), LED_ALPHA7.10 (DP), LED_ALPHA8.10 (DP), LED_ALPHA9.10 (DP), LED_ALPHA10.10 (DP), LED_ALPHA11.10 (DP), LED_ALPHA12.10 (DP), R17.2
SEG_E: LED_ALPHA1.9 (E), LED_ALPHA2.9 (E), LED_ALPHA3.9 (E), LED_ALPHA4.9 (E), LED_ALPHA5.9 (E), LED_ALPHA6.9 (E), LED_ALPHA7.9 (E), LED_ALPHA8.9 (E), LED_ALPHA9.9 (E), LED_ALPHA10.9 (E), LED_ALPHA11.9 (E), LED_ALPHA12.9 (E), R4.2
SEG_F: LED_ALPHA1.8 (F), LED_ALPHA2.8 (F), LED_ALPHA3.8 (F), LED_ALPHA4.8 (F), LED_ALPHA5.8 (F), LED_ALPHA6.8 (F), LED_ALPHA7.8 (F), LED_ALPHA8.8 (F), LED_ALPHA9.8 (F), LED_ALPHA10.8 (F), LED_ALPHA11.8 (F), LED_ALPHA12.8 (F), R5.2
SEG_G: LED_ALPHA1.6 (G), LED_ALPHA2.6 (G), LED_ALPHA3.6 (G), LED_ALPHA4.6 (G), LED_ALPHA5.6 (G), LED_ALPHA6.6 (G), LED_ALPHA7.6 (G), LED_ALPHA8.6 (G), LED_ALPHA9.6 (G), LED_ALPHA10.6 (G), LED_ALPHA11.6 (G), LED_ALPHA12.6 (G), R6.2
SEG_H: LED_ALPHA1.5 (H), LED_ALPHA2.5 (H), LED_ALPHA3.5 (H), LED_ALPHA4.5 (H), LED_ALPHA5.5 (H), LED_ALPHA6.5 (H), LED_ALPHA7.5 (H), LED_ALPHA8.5 (H), LED_ALPHA9.5 (H), LED_ALPHA10.5 (H), LED_ALPHA11.5 (H), LED_ALPHA12.5 (H), R7.2
SEG_K: LED_ALPHA1.4 (K), LED_ALPHA2.4 (K), LED_ALPHA3.4 (K), LED_ALPHA4.4 (K), LED_ALPHA5.4 (K), LED_ALPHA6.4 (K), LED_ALPHA7.4 (K), LED_ALPHA8.4 (K), LED_ALPHA9.4 (K), LED_ALPHA10.4 (K), LED_ALPHA11.4 (K), LED_ALPHA12.4 (K), R8.2
SEG_M: LED_ALPHA1.3 (M), LED_ALPHA2.3 (M), LED_ALPHA3.3 (M), LED_ALPHA4.3 (M), LED_ALPHA5.3 (M), LED_ALPHA6.3 (M), LED_ALPHA7.3 (M), LED_ALPHA8.3 (M), LED_ALPHA9.3 (M), LED_ALPHA10.3 (M), LED_ALPHA11.3 (M), LED_ALPHA12.3 (M), R9.2
SEG_N: LED_ALPHA1.17 (N), LED_ALPHA2.17 (N), LED_ALPHA3.17 (N), LED_ALPHA4.17 (N), LED_ALPHA5.17 (N), LED_ALPHA6.17 (N), LED_ALPHA7.17 (N), LED_ALPHA8.17 (N), LED_ALPHA9.17 (N), LED_ALPHA10.17 (N), LED_ALPHA11.17 (N), LED_ALPHA12.17 (N), R10.2
SEG_P: LED_ALPHA1.15, LED_ALPHA2.15, LED_ALPHA3.15, LED_ALPHA4.15, LED_ALPHA5.15, LED_ALPHA6.15, LED_ALPHA7.15, LED_ALPHA8.15, LED_ALPHA9.15, LED_ALPHA10.15, LED_ALPHA11.15, LED_ALPHA12.15, R11.2
SEG_R: LED_ALPHA1.12 (R), LED_ALPHA2.12 (R), LED_ALPHA3.12 (R), LED_ALPHA4.12 (R), LED_ALPHA5.12 (R), LED_ALPHA6.12 (R), LED_ALPHA7.12 (R), LED_ALPHA8.12 (R), LED_ALPHA9.12 (R), LED_ALPHA10.12 (R), LED_ALPHA11.12 (R), LED_ALPHA12.12 (R), R12.2
SEG_S: LED_ALPHA1.11 (S), LED_ALPHA2.11 (S), LED_ALPHA3.11 (S), LED_ALPHA4.11 (S), LED_ALPHA5.11 (S), LED_ALPHA6.11 (S), LED_ALPHA7.11 (S), LED_ALPHA8.11 (S), LED_ALPHA9.11 (S), LED_ALPHA10.11 (S), LED_ALPHA11.11 (S), LED_ALPHA12.11 (S), R13.2
SEG_T: LED_ALPHA1.7 (T), LED_ALPHA2.7 (T), LED_ALPHA3.7 (T), LED_ALPHA4.7 (T), LED_ALPHA5.7 (T), LED_ALPHA6.7 (T), LED_ALPHA7.7 (T), LED_ALPHA8.7 (T), LED_ALPHA9.7 (T), LED_ALPHA10.7 (T), LED_ALPHA11.7 (T), LED_ALPHA12.7 (T), R14.2
SEG_U: LED_ALPHA1.14 (U), LED_ALPHA2.14 (U), LED_ALPHA3.14 (U), LED_ALPHA4.14 (U), LED_ALPHA5.14 (U), LED_ALPHA6.14 (U), LED_ALPHA7.14 (U), LED_ALPHA8.14 (U), LED_ALPHA9.14 (U), LED_ALPHA10.14 (U), LED_ALPHA11.14 (U), LED_ALPHA12.14 (U), R16.2
SER: J1.2, U1.14 (SER)
SRCLK: J1.3, U1.11 (SRCLK), U2.11 (SRCLK), U3.11 (SRCLK), U4.11 (SRCLK), U5.11 (SRCLK)
