njKessel/ESP32s3-NetworkClock/src/display_font.cpp

// display_font.cpp

#include "display_font.h"
#include <cstddef>  

inline uint32_t blank = SEG_ALL; // ALL SEGMENTS BLANK (ACTIVE LOW)

static uint32_t fontTable[128] = {}; // zero-initialized for all ASCII

void initFontTable() {
    //               A       B       C       D       E       F       G       H       K       M       N       P       R       S       T       U
    fontTable['0'] = SEG_A | SEG_B | SEG_C | SEG_D | SEG_E | SEG_F | SEG_G | SEG_H;
    fontTable['1'] =                 SEG_C | SEG_D;
    fontTable['2'] = SEG_A | SEG_B | SEG_C |         SEG_E | SEG_F | SEG_G |                                 SEG_P |                         SEG_U;
    fontTable['3'] = SEG_A | SEG_B | SEG_C | SEG_D | SEG_E | SEG_F |                                         SEG_P |                         SEG_U;
    fontTable['4'] =                 SEG_C | SEG_D |                         SEG_H |                         SEG_P |                         SEG_U;
    fontTable['5'] = SEG_A | SEG_B |         SEG_D | SEG_E | SEG_F |         SEG_H |                         SEG_P |                         SEG_U;
    fontTable['6'] = SEG_A | SEG_B |         SEG_D | SEG_E | SEG_F | SEG_G | SEG_H |                         SEG_P |                         SEG_U;
    fontTable['7'] = SEG_A | SEG_B | SEG_C | SEG_D;
    fontTable['8'] = SEG_A | SEG_B | SEG_C | SEG_D | SEG_E | SEG_F | SEG_G | SEG_H |                         SEG_P |                         SEG_U;
    fontTable['9'] = SEG_A | SEG_B | SEG_C | SEG_D | SEG_E | SEG_F |         SEG_H |                         SEG_P |                         SEG_U;

    fontTable['<'] =                                                                                 SEG_N |         SEG_R;
    fontTable['>'] =                                                                 SEG_K |                                         SEG_T;
    fontTable['#'] = SEG_A | SEG_B | SEG_C | SEG_D | SEG_E | SEG_F | SEG_G | SEG_H | SEG_K | SEG_M | SEG_N | SEG_P | SEG_R | SEG_S | SEG_T | SEG_U;

    fontTable[' '] = 0;
    fontTable['!'] =                 SEG_C | SEG_D;
    fontTable['"'] =                 SEG_C |                                 SEG_H;
    fontTable['$'] = SEG_A | SEG_B |         SEG_D | SEG_E | SEG_F |         SEG_H |         SEG_M |         SEG_P |         SEG_S |         SEG_U;
    fontTable['%'] =                         SEG_D |                 SEG_G |         SEG_K |                 SEG_P |                 SEG_T;
    fontTable['&'] = SEG_A |                 SEG_D | SEG_E | SEG_F |         SEG_H | SEG_K |                 SEG_P |                 SEG_T;
    fontTable['\'']=                 SEG_C;
    fontTable['('] =                                                                                 SEG_N |                 SEG_R;
    fontTable[')'] =                                                                 SEG_K |                                         SEG_T;
    fontTable['*'] =                                                                 SEG_K | SEG_M | SEG_N | SEG_P | SEG_R | SEG_S | SEG_T | SEG_U;
    fontTable['+'] =                                                                         SEG_M |         SEG_P |         SEG_S |         SEG_U;
    fontTable[','] =                                                                                                                 SEG_T;
    fontTable['-'] =                                                                                         SEG_P |                         SEG_U;
    fontTable['.'] =                                 SEG_E;
    fontTable['/'] =                                                                                 SEG_N |                         SEG_T;
    fontTable[':'] =                 SEG_C |         SEG_E;
    fontTable[';'] =                 SEG_C |                                                                                         SEG_T;
    fontTable['='] =                                 SEG_E | SEG_F |                                         SEG_P |                         SEG_U;
    fontTable['?'] = SEG_A | SEG_B | SEG_C |                                                                 SEG_P |  SEG_S;
    fontTable['@'] = SEG_A | SEG_B | SEG_C | SEG_D | SEG_E | SEG_F | SEG_G | SEG_H |                         SEG_P;
    fontTable['['] = SEG_A |                                 SEG_F | SEG_G | SEG_H;
    fontTable['\\']=                                                                 SEG_K |                 SEG_R;
    fontTable[']'] =         SEG_B | SEG_C | SEG_D | SEG_E;
    fontTable['^'] =                                                                                                 SEG_R |         SEG_T;
    fontTable['_'] =                                 SEG_E | SEG_F;
    fontTable['`'] =                                                                 SEG_K;
    fontTable['{'] =                                                 SEG_G | SEG_H |                         SEG_P;
    fontTable['|'] =                                                                         SEG_M |                         SEG_S;
    fontTable['}'] =                 SEG_C | SEG_D |                                                                                 SEG_U;
    fontTable['~'] = SEG_A |                                                                                                         SEG_U;

    fontTable['A'] = SEG_A | SEG_B | SEG_C | SEG_D |                 SEG_G | SEG_H |                         SEG_P |                         SEG_U;
    fontTable['B'] = SEG_A | SEG_B | SEG_C | SEG_D | SEG_E | SEG_F |                         SEG_M |         SEG_P |         SEG_S;
    fontTable['C'] = SEG_A | SEG_B |                 SEG_E | SEG_F | SEG_G | SEG_H;
    fontTable['D'] = SEG_A | SEG_B | SEG_C | SEG_D | SEG_E | SEG_F |                         SEG_M |                         SEG_S;
    fontTable['E'] = SEG_A | SEG_B |                 SEG_E | SEG_F | SEG_G | SEG_H |                         SEG_P |                         SEG_U;
    fontTable['F'] = SEG_A | SEG_B |                                 SEG_G | SEG_H |                         SEG_P |                         SEG_U;
    fontTable['G'] = SEG_A | SEG_B |         SEG_D | SEG_E | SEG_F | SEG_G | SEG_H |                         SEG_P;
    fontTable['H'] =                 SEG_C | SEG_D |                 SEG_G | SEG_H |                         SEG_P |                         SEG_U;
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
    fontTable['n'] =                         SEG_D |                 SEG_G |                                 SEG_P |                         SEG_U;
    fontTable['o'] =                         SEG_D | SEG_E | SEG_F | SEG_G |                                 SEG_P |                         SEG_U;
    fontTable['p'] = SEG_A | SEG_B | SEG_C |                         SEG_G | SEG_H |                         SEG_P |                         SEG_U;
    fontTable['q'] = SEG_A | SEG_B | SEG_C | SEG_D |                         SEG_H |                         SEG_P |                         SEG_U;
    fontTable['r'] =                                                 SEG_G |                                 SEG_P;
    fontTable['s'] = SEG_A | SEG_B |         SEG_D | SEG_E | SEG_F |         SEG_H |                         SEG_P |                         SEG_U;
    fontTable['t'] =                                 SEG_E | SEG_F | SEG_G | SEG_H |                         SEG_P |                         SEG_U;
    fontTable['u'] =                         SEG_D | SEG_E | SEG_F | SEG_G;
    fontTable['v'] =                                                                                                 SEG_R |         SEG_T;
    fontTable['w'] =                         SEG_D |                 SEG_G |                                         SEG_R |         SEG_T;
    fontTable['x'] =                                                                 SEG_K |         SEG_N |         SEG_R |         SEG_T;
    fontTable['y'] =                                                                 SEG_K |         SEG_N |                 SEG_S;
    fontTable['z'] = SEG_A | SEG_B |                 SEG_E | SEG_F |                                 SEG_N |                         SEG_T;

    // Weather
    fontTable[1] =                                                                 SEG_K | SEG_M | SEG_N | SEG_P | SEG_R | SEG_S | SEG_T | SEG_U;
    fontTable[2] =                                 SEG_E | SEG_F | SEG_G |         SEG_K | SEG_M | SEG_N | SEG_P | SEG_R |                 SEG_U;
    fontTable[3] = SEG_A |                         SEG_E | SEG_F | SEG_G |         SEG_K | SEG_M |                 SEG_R |                 SEG_U;
    fontTable[4] = SEG_A | SEG_B | SEG_C | SEG_D |                 SEG_G | SEG_H |                         SEG_P | SEG_R |         SEG_T | SEG_U;
    fontTable[5] = SEG_A | SEG_B | SEG_C | SEG_D |         SEG_F |         SEG_H |                                                 SEG_T;
    fontTable[6] = SEG_A | SEG_B | SEG_C | SEG_D |                         SEG_H |                                 SEG_R | SEG_S | SEG_T;
    fontTable[7] = SEG_A | SEG_B |                 SEG_E |                                                                                 SEG_U;
    fontTable[8] =         SEG_B | SEG_C |                                                 SEG_M |         SEG_P;
}

enum anodeBit : uint64_t {
  ANODE0 = 1ull << 24,  // 74HC595 U4 pin ANODE1 on 12C-LTP-587HR_rev1
  ANODE1 = 1ull << 25,
  ANODE2 = 1ull << 26,
  ANODE3 = 1ull << 27,
  ANODE4 = 1ull << 28,
  ANODE5 = 1ull << 29,
  ANODE6 = 1ull << 30,
  ANODE7 = 1ull << 31,
  ANODE8 = 1ull << 32,
  ANODE9 = 1ull << 33,
  ANODE10 = 1ull << 34,
  ANODE11 = 1ull << 35, // 74HC595 U5 pin ANODE12 on 12C-LTP-587HR_rev1

  STATUS_LED1 = 1ull << 37,
  STATUS_LED2 = 1ull << 38,
  STATUS_LED3 = 1ull << 39
};

uint32_t getSegmentPattern(char c, bool DP) {
    if ((unsigned char)c < sizeof(fontTable)/sizeof(fontTable[0])) {
        if (DP) {
            return fontTable[(unsigned char)c] | SEG_DP;
        } else {
            return fontTable[(unsigned char)c];
        }
    } else {
        return 0;
    }
}

const uint64_t anodeMap[12] = {
  ANODE0, ANODE1, ANODE2, ANODE3, ANODE4, ANODE5, 
  ANODE6, ANODE7, ANODE8, ANODE9, ANODE10, ANODE11
};

void displayBuilder(const char* str, uint64_t* displayWords, bool navDelay) {
    size_t stringIdx = 0;
    size_t strLen = strlen(str);

    for (int dIdx = 0; dIdx < 12; dIdx++) {
        uint32_t segments = 0;

        if (navDelay) { // WITH NAVIGATION ARROWS
            if (dIdx == 0) {
                segments = getSegmentPattern('<', false);
                stringIdx++;
            } 
            else if (dIdx == 11) {
                segments = getSegmentPattern('>', false);
            } 
            else if (stringIdx < strLen) {
                bool hasDP = (stringIdx + 1 < strLen && (str[stringIdx + 1] == '.' || str[stringIdx + 1] == ':'));
                segments = getSegmentPattern(str[stringIdx], hasDP);
                if (hasDP) stringIdx++;
                stringIdx++;
            }
        } else { // WITHOUT NAVIGATION ARROWS
            if (stringIdx < strLen) {
                bool hasDP = (stringIdx + 1 < strLen && (str[stringIdx + 1] == '.' || str[stringIdx + 1] == ':'));
                segments = getSegmentPattern(str[stringIdx], hasDP);
                if (hasDP) stringIdx++;
                stringIdx++;
            }
        }

        uint64_t segmentData = (uint64_t)(segments & 0x1FFFF); 
        displayWords[dIdx] = anodeMap[dIdx] | segmentData;

        extern int WiFiLight;
        if (WiFiLight == 1) {
            displayWords[dIdx] |= STATUS_LED1;
        }
        extern int alarmLight;
        if (alarmLight == 1) {
            displayWords[dIdx] |= STATUS_LED2;
        }
        extern int timerLight;
        if (timerLight == 1) {
            displayWords[dIdx] |= STATUS_LED3;
        }
    }
}
