njKessel/ESP32s3-NetworkClock/src/features/networking.cpp

//////////////////////////////////////////////////////////////
// INCLUDES  /////////////////////////////////////////////////
//////////////////////////////////////////////////////////////
#include "networking.h"

volatile bool globalWiFiConnected = false;

//////////////////////////////////////////////////////////////
// ASYNC EVENTS //////////////////////////////////////////////
//////////////////////////////////////////////////////////////
void WiFiEvent(WiFiEvent_t event) {                         // The ESP32 Wi-Fi stack runs on a background FreeRTOS task. 
    if (event == ARDUINO_EVENT_WIFI_STA_GOT_IP) {           // This callback lets us track connection state instantly 
        globalWiFiConnected = true;                         // without blocking or constantly polling in the main loop.
    } else if (event == ARDUINO_EVENT_WIFI_STA_DISCONNECTED) {
        globalWiFiConnected = false;
    }
}

//////////////////////////////////////////////////////////////
// INITIALIZATION ////////////////////////////////////////////
//////////////////////////////////////////////////////////////
Networking::Networking() {
    menuState = NET_INIT;
    listIndex = 0;
    networkCount = 0;
    savedSSID = "";
    savedPassword = "";
}

void Networking::begin() {
    Serial.println("DBG 040 NETWK: Starting WiFI Connection");
    
    WiFi.onEvent(WiFiEvent);
    
    WiFi.mode(WIFI_STA);
    WiFi.disconnect(false, true);                           // Clear any residual cached connections in the ESP-IDF base
    delay(50);
    
    prefs.begin("wifi", false);
    
    if (prefs.isKey("ssid")) {
        savedSSID = prefs.getString("ssid", "").c_str();
        savedPassword = prefs.getString("pass", "").c_str();
        Serial.println("DBG 042 NETWK: Connecting to saved network");
        WiFi.begin(savedSSID.c_str(), savedPassword.c_str());
    } else {
        Serial.println("DBG 043 NETWK: No network saved");
        savedSSID = "";
        savedPassword = "";
    }
}

void Networking::saveCredentials() {
    Serial.println("DBG 044 NETWK: Saving Network Credentials");
    prefs.putString("ssid", savedSSID.c_str());
    prefs.putString("pass", savedPassword.c_str());
}

void Networking::factoryReset() {
    Serial.println("DBG 04F NETWK: Network Settings Factory Reset");
    prefs.begin("wifi", false);
    prefs.clear();
    savedSSID = "";
    savedPassword = "";
    WiFi.disconnect(true, true);                            // Erase credentials and force radio disconnect
}

void Networking::reset() {
    menuState = NET_INIT;
    listIndex = 0;
    scannedNetworks.clear();
}

//////////////////////////////////////////////////////////////
// MENU NAVIGATION ///////////////////////////////////////////
//////////////////////////////////////////////////////////////
void Networking::onKnobTurn(int direction) {
    if (menuState == NET_SELECT_SSID && !scannedNetworks.empty()) {
        listIndex += direction;
        
        int maxIndex = scannedNetworks.size() - 1;
        
        if (listIndex < 0) {
            listIndex = maxIndex;
        } else if (listIndex > maxIndex) {
            listIndex = 0;
        }
    }
}

void Networking::onButtonPress() {
    if (menuState == NET_INIT || menuState == NET_FAILED) {
        startScan();
    } else if (menuState == NET_SELECT_SSID) {
        savedSSID = scannedNetworks[listIndex];
    }
}

//////////////////////////////////////////////////////////////
// NETWORK OPERATIONS ////////////////////////////////////////
//////////////////////////////////////////////////////////////
void Networking::startScan() {
    Serial.println("DBG 045 NETWK: Starting Network Scan");
    menuState = NET_SCANNING;
    scannedNetworks.clear();
    
    networkCount = WiFi.scanNetworks();                     // Note: This is blocking. UI will freeze until scan completes.
    
    if (networkCount > 0) {
        for (int i = 0; i < networkCount; ++i) {
            scannedNetworks.push_back(WiFi.SSID(i).c_str());
        }
    }
    
    scannedNetworks.push_back("CUSTOM");                    // Always provide a fallback for hidden networks
    
    listIndex = 0;
    menuState = NET_SELECT_SSID;
}

void Networking::setTargetSSID(std::string ssid) {
    savedSSID = ssid;
}

void Networking::setTargetPassword(std::string pass) {
    savedPassword = pass;
}

void Networking::connectToTarget() {
    menuState = NET_CONNECTING;
    connectionStartTime = millis();
    
    WiFi.disconnect();
    WiFi.begin(savedSSID.c_str(), savedPassword.c_str());
    Serial.println("DBG 090 NETWK: Connecting to network ");
}

bool Networking::isConnected() {
    return globalWiFiConnected;
}

std::string Networking::getCurrentSSID() {
    return savedSSID;
}

bool Networking::isCustomSelected() {
    if (scannedNetworks.empty()) return false;
    return scannedNetworks[listIndex] == "CUSTOM";
}

//////////////////////////////////////////////////////////////
// STATE & DISPLAY ///////////////////////////////////////////
//////////////////////////////////////////////////////////////
NetworkMenuState Networking::getMenuState() {
                                                            // This acts as the logic "tick" for connection attempts,
                                                            // managing the 10-second timeout rather than just returning state.
    if (menuState == NET_CONNECTING) {
        if (globalWiFiConnected) {
            if (millis() - connectionStartTime >= 1000) {
                menuState = NET_CONNECTED;
                connectedTime = millis(); 
                saveCredentials();
                Serial.println("DBG 090 NETWK: Connected to network ");
            }
        } else if (millis() - connectionStartTime > 10000) {
            menuState = NET_FAILED;
            Serial.println("DBG 090 NETWK: Failed to connect to network ");
        }
    }
    return menuState;
}

std::string Networking::getDisplayString() {
    std::string text = "";
    int targetLength = 12; 

    switch (menuState) {
        case NET_INIT:          text = "FIND NET"; break;
        case NET_SCANNING:      text = "SCANNING"; break;
        case NET_SELECT_SSID:
            if (!scannedNetworks.empty()) {
                text = scannedNetworks[listIndex];
                
                if (text.length() > 8) {                    // Cap at 8 chars to leave room for the "<" and ">" nav arrows
                    text = text.substr(0, 8);
                }
            } else {
                text = "NO NETS";
            }
            break;
        case NET_CONNECTING:    text = "CONNECTING"; break;
        case NET_CONNECTED:     text = "SUCCESS"; break;
        case NET_FAILED:        text = "FAILED"; break;
    }

                                                            // Calculate dynamic center-padding
    int padding = targetLength - text.length();
    if (padding > 0) {
        int padLeft = padding / 2;
        int padRight = padding - padLeft;
        text = std::string(padLeft, ' ') + text + std::string(padRight, ' ');
    }

    return text;
}
