njKessel/ESP32s3-NetworkClock/src/features/stopwatch.h

#ifndef STOPWATCH_H
#define STOPWATCH_H

#include <Arduino.h>

class Stopwatch {
    private:
        bool running;
        unsigned long long startTime;
        unsigned long long accumulatedTime;

    public:
        Stopwatch();
        void toggle();                  // On/off
        void reset();
        String getFormattedTime();
};

#endif
