njKessel/ESP32s3-NetworkClock/include/secrets.example.h

#pragma once

// Weather API
#define OWM_USE_SECRETS "no" // Change "no" to "yes" (case sensitive) to override on-device settings with these
#define OWM_API_KEY "0"
#define OWM_LAT "0"
#define OWM_LON "0"
