njKessel/ESP32s3-NetworkClock/(commit log)

2025-10-01 chore: initial commit (ESP32-S3 LCD bring-up)
2025-10-01 feat: show HH:MM:SS on line 1 and TZ on line 2 (ESP32-S3 + NTP)
2025-10-06 Rename folder to ESP32clock, refactor for clarity, update LCD code
2025-10-06 docs folder, circuit diagram for LCD, moving to 7seg LED
2025-10-06 wip: HT16K33 bring-up; wiring; Adafruit_7segment in overflow, switch to raw 8-digit next
2025-10-27 Cleanup reset main and .gitignore encoding fix
    [displayInit.h, main.cpp]
2025-10-30 Add hurdles section to README
    Added hurdles section explaining challenges with I2C and display.
2025-10-31 added displaymapping reference file with traced digit bytes
2025-11-05 Final functioning LED display with circuit diagram for current clock, scope screen of SDA
2025-11-25 added display testing board schema and pcb (kicad pdf)
2025-12-15 Begin of SPI display logic
2025-12-18 Worked on display logic and SPI
2025-12-30 Display solder reflow and troubleshooting, now able to display via shift regs
2026-01-02 Reworked many functions, collapsed into a single render function, added many comments for future understanding, functioning time zone menu, fixed debounce
    [display_font.cpp, main.cpp]
2026-01-13 Redesigned display board about a week ago, will update hardware docs when board delivered
2026-01-18 Update README with project hurdles and future plans
    Removed optional VFD display upgrade from future plans. Expanded on the hurdles faced in developing a custom shift-register based driver for the display modules, including details on PCB revisions and improvements.
2026-01-20 Added image of clock in current state
2026-01-22 font table format fix, add cursor, alarm edit feature begin
    [display_font.cpp, main.cpp]
2026-01-22 added kicad files to docs/hardware/PCB/breadboardDisplayPCB/displayboard/
    [displayboard.kicad_pcb, displayboard.kicad_sch]
2026-01-22 moved hardware out of docs
    [displayboard.kicad_pcb, displayboard.kicad_sch]
2026-01-26 time zone menu fix
    [main.cpp]
2026-01-27 timer class logic
2026-01-27 timer class logic complete, edit next
2026-01-27 timerBuffer fix
2026-01-27 timer pause fix and count fix, add timer header to main
    [alarm.h, main.cpp, timer.cpp]
2026-01-27 add mod and home button logic, hardware, pins
2026-01-27 timer selector debug and init fix
    [main.cpp, timer.cpp]
2026-01-27 timer countdown seconds added and debug start, removed syncing from main
    timer countdown seconds added and debug start, removed syncing from main
2026-01-28 begin work on final display PCB
    [clockDisplay.kicad_pcb, clockDisplay.kicad_sch, displayboard.kicad_pcb, displayboard.kicad_sch]
2026-01-29 clock h initial setup + PCB rev3 parts delivered
2026-02-01 Clock constructor, button press logic
2026-02-01 clock mod button logic
2026-02-09 final PCB rev work
    [displayboard.kicad_pcb, displayboard.kicad_sch]
2026-02-12 soldered new PCB (rev3) and corrected displayBuilder to reflect inversion of segment bits
    [display_font.cpp]
2026-02-17 rev 4 PCB design finalized for display
    [displayboard.kicad_pcb]
2026-02-17 removed old main PCB file and begin on main board in mainClockPCB
    [clockDisplay.kicad_sch, mainClockPCB.kicad_pcb, mainClockPCB.kicad_sch]
2026-02-17 continue on main PCB, minor main.cpp changes for analog light sensor, RTC
    [mainClockPCB.kicad_sch]
2026-02-24 add home button logic to clock function
2026-02-24 removed time funtions from main and added timeUtil replacements
    [main.cpp]
2026-02-24 PCB buzzer sound chip work
    [mainClockPCB.kicad_pcb, mainClockPCB.kicad_sch]
2026-02-26 clean up of display pins on main board schema
2026-02-26 clean up of USB, piezo, buttons
    [mainClockPCB.kicad_sch]
2026-02-26 voltage regulator schema cleanup
2026-02-26 previous commit file fix
    [mainClockPCB.kicad_sch]
2026-02-26 enable/boot/reset button schema cleanup
    [mainClockPCB.kicad_sch]
2026-02-26 encoder schema cleanup
    [mainClockPCB.kicad_sch]
2026-02-26 ESP32 schema cleanup
    [mainClockPCB.kicad_sch]
2026-02-26 button header amd PISO register
2026-02-26 expansion/debug/jtag/strap headers
    [mainClockPCB.kicad_sch]
2026-02-26 net label fixes
    [mainClockPCB.kicad_pcb, mainClockPCB.kicad_sch]
2026-02-26 power flags
    [mainClockPCB.kicad_sch]
2026-02-26 begin PCB design. Component layout early draft, fills, edge cuts, board setup
    [mainClockPCB.kicad_pcb]
2026-02-26 PCB design complete
    [mainClockPCB.kicad_pcb, mainClockPCB.kicad_sch]
2026-02-27 initial BOM generation
    [bom.csv, designators.csv, mainClockPCB.kicad_sch, positions.csv]
2026-03-24 large commit of PCB progress
    [bom.csv, buttons.kicad_pcb, buttons.kicad_sch, designators.csv, displayboard.kicad_pcb, displayboard.kicad_sch, mainClockPCB.kicad_pcb, mainClockPCB.kicad_sch]
2026-04-14 bypass cap on PISO S
    [bom.csv, designators.csv, mainClockPCB.kicad_pcb, mainClockPCB.kicad_sch, positions.csv]
2026-04-21 KiCad 10 update, clock funtion fixes
    [displayboard.kicad_pcb, displayboard.kicad_sch, displayboard.step]
2026-04-21 working focus timer
2026-04-23 Added blanking interval to render
    [bom.csv, buttons.kicad_pcb, buttons.kicad_sch, designators.csv, displayboard.kicad_pcb, mainClockPCB.kicad_pcb, positions.csv]
2026-04-24 Revise README with project details and features
    Expanded project details, added current features, hurdles, and planned features sections.
2026-06-30 Serial header on mainboard now matches FTDI standard, JTAG changed to be more standard
    [mainClockPCB.kicad_sch]
2026-06-30 fixed PCB routing for JTAG and serial headers
    [mainClockPCB.kicad_pcb, mainClockPCB.kicad_sch]
2026-07-16 Fixed Y1 hole spacing for issue #1
    [mainClockPCB.kicad_pcb]
2026-07-16 Adjusted expansion bay placement to reduce knob conflict
    [mainClockPCB.kicad_pcb]
2026-08-13 logic updated for final display PCB
    [bom.csv, mainClockPCB.kicad_pcb, positions.csv]
2026-08-25 display pin changes for final PCB
2026-09-03 PISO shift register button handling and schematic/BOM fixes
    [mainClockPCB.kicad_sch]
2026-09-17 added the rest of printable ASCII char to the fonttable
2026-09-17 added rest of buttons
2026-09-21 changed encoder so it loads into ram with DRAM_ATTR
2026-09-21 added cred wipe for factory reset
    [networking.cpp]
2026-09-21 timer and timezone debug messages
2026-09-21 fixed keyboard includes and more main debug messages
    [keyboard.cpp, main.cpp]
2026-09-21 timer debug call positioning fix
    [timer.cpp]
2026-09-28 Global/pin def commenting improvements
2026-09-28 continued documentation for globals and pin def
2026-09-28 Encoder logic comment updates, clockTool rename for intellisense
2026-09-29 fixed stopwatch debug message
    [main.cpp]
2026-09-29 removed old time display function and improved comments on display and button functions
2026-09-29 improved comments on encoder polling
2026-09-29 inital weather framework
2026-09-30 local temperature
2026-09-30 local temp display adjustments, stray fix
    [main.cpp]
2026-10-01 fixed RTC blocking display, documentation in networking.*, notification.h, stopwatch.*
    [clock.cpp, networking.cpp, networking.h, notification.h, stopwatch.cpp, stopwatch.h]
2026-10-01 improved setup docs, fixed alarm 24hr toggle
    [clock.cpp, clock.h, main.cpp]
2026-10-01 loop start comments and button detection
2026-10-01 Revise README for ESP32-S3 Network Clock
    Updated project description and features in README.
